L31N/QSD67LC/README.md

View this project on [CADLAB.io](https://cadlab.io/project/1322). 

# QSD67LC
Quickshifter for Triumph Daytona 675 Bj. 06-08
