L31N/QSD67LC/qsd67lc.sch.pdf

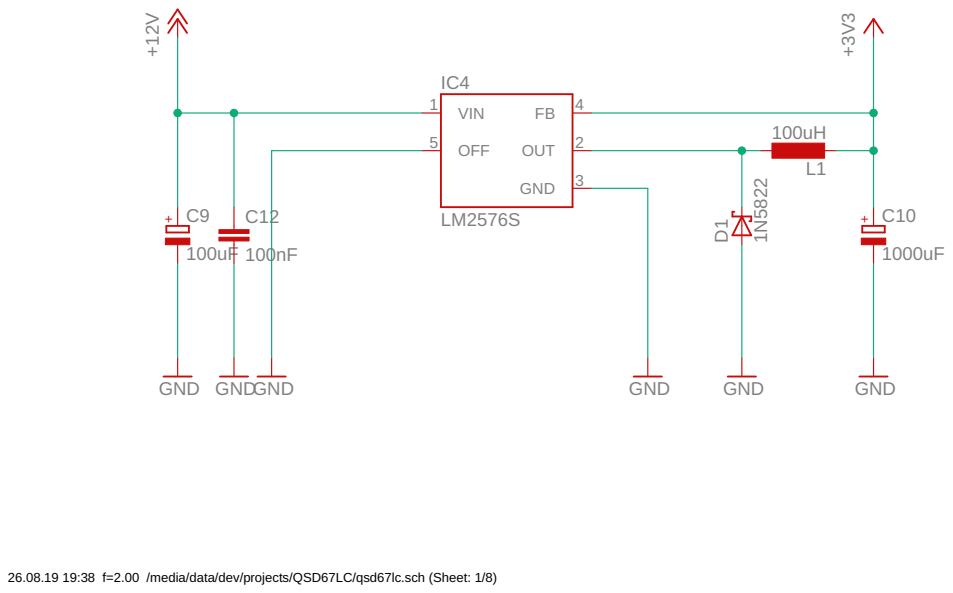
[picture p1: page 1]

26.08.19 19:38 f=2.00 /media/data/dev/projects/QSD67LC/qsd67lc.sch (Sheet: 1/8)

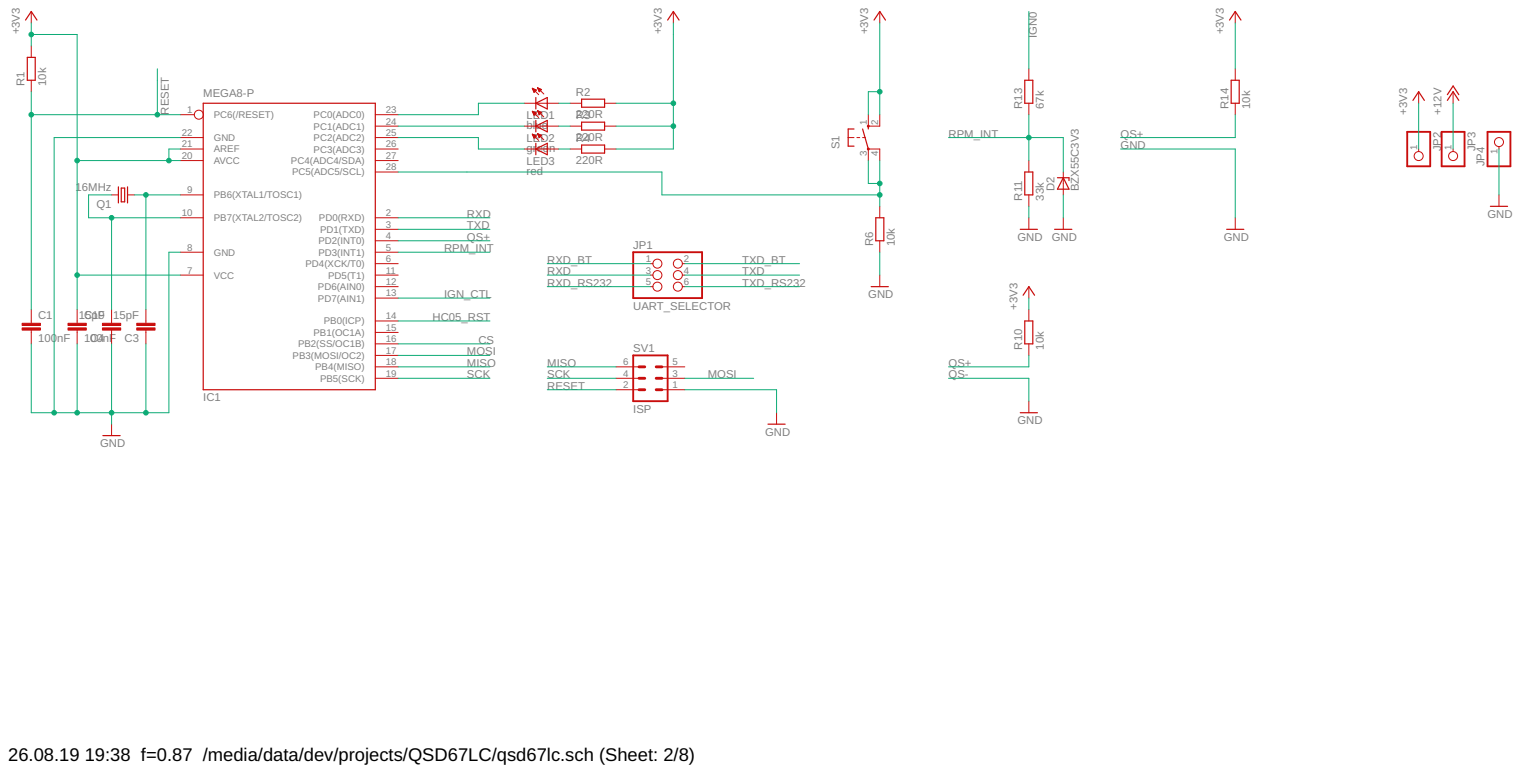
[picture p2: page 2]

26.08.19 19:38 f=0.87 /media/data/dev/projects/QSD67LC/qsd67lc.sch (Sheet: 2/8)

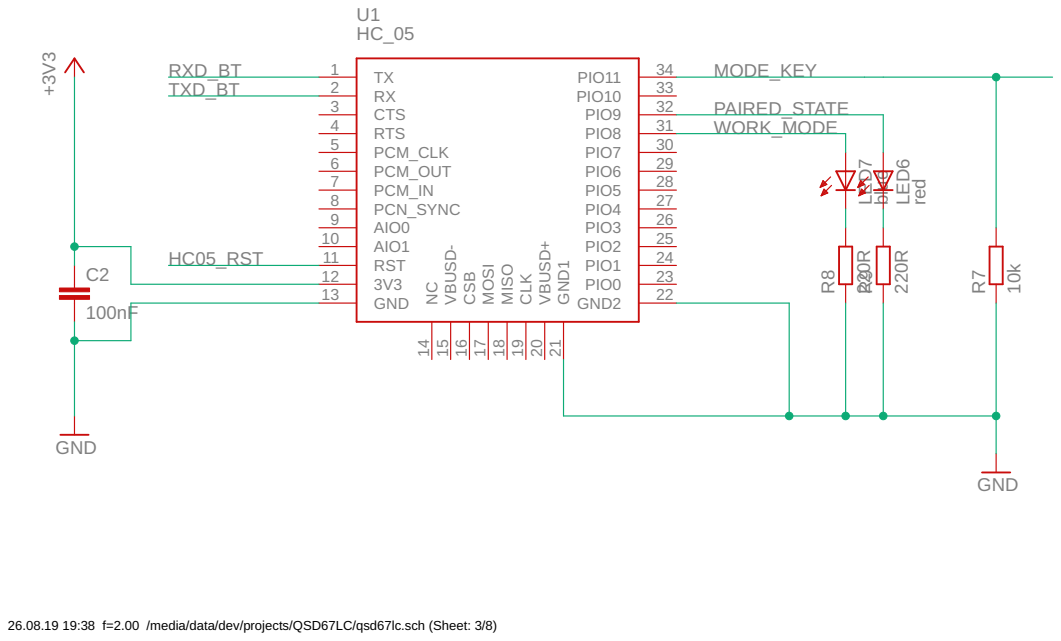
[picture p3: page 3]

26.08.19 19:38 f=2.00 /media/data/dev/projects/QSD67LC/qsd67lc.sch (Sheet: 3/8)

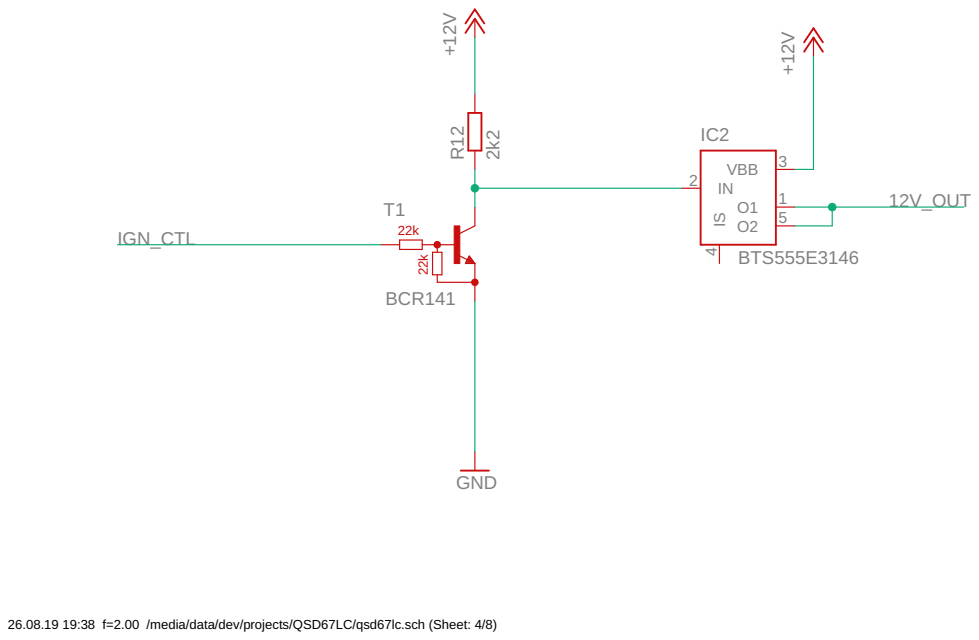
[picture p4: page 4]

26.08.19 19:38 f=2.00 /media/data/dev/projects/QSD67LC/qsd67lc.sch (Sheet: 4/8)

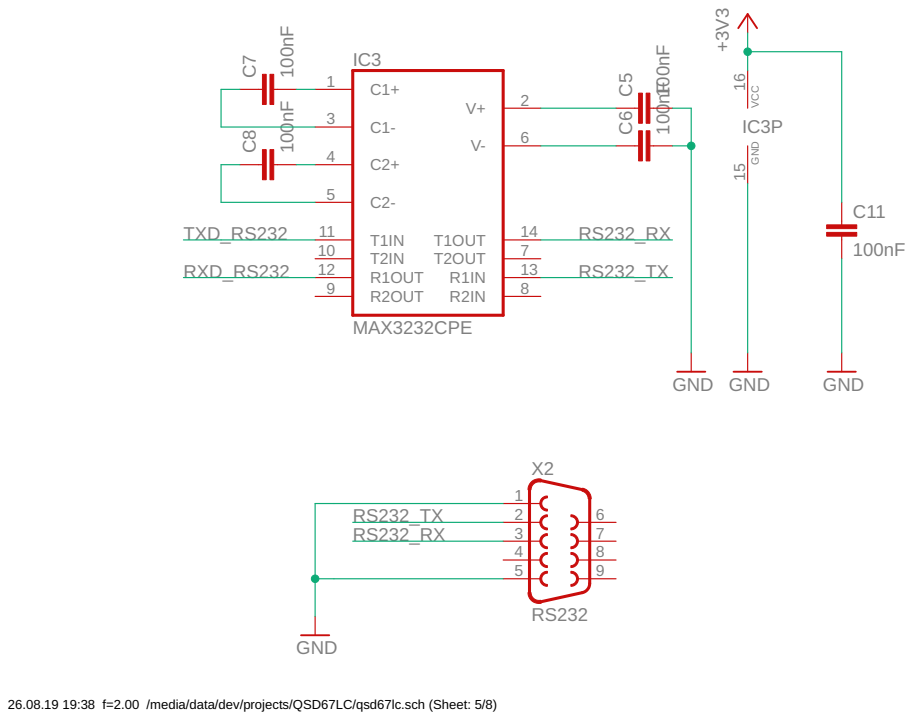
[picture p5: page 5]

26.08.19 19:38 f=2.00 /media/data/dev/projects/QSD67LC/qsd67lc.sch (Sheet: 5/8)

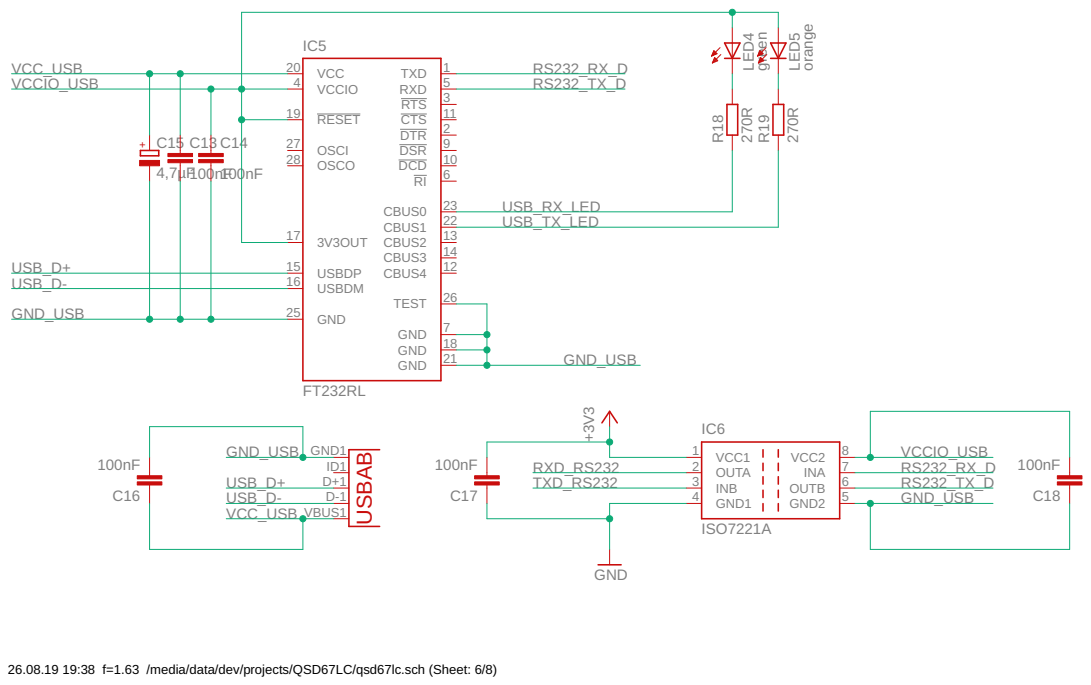
[picture p6: page 6]

26.08.19 19:38 f=1.63 /media/data/dev/projects/QSD67LC/qsd67lc.sch (Sheet: 6/8)

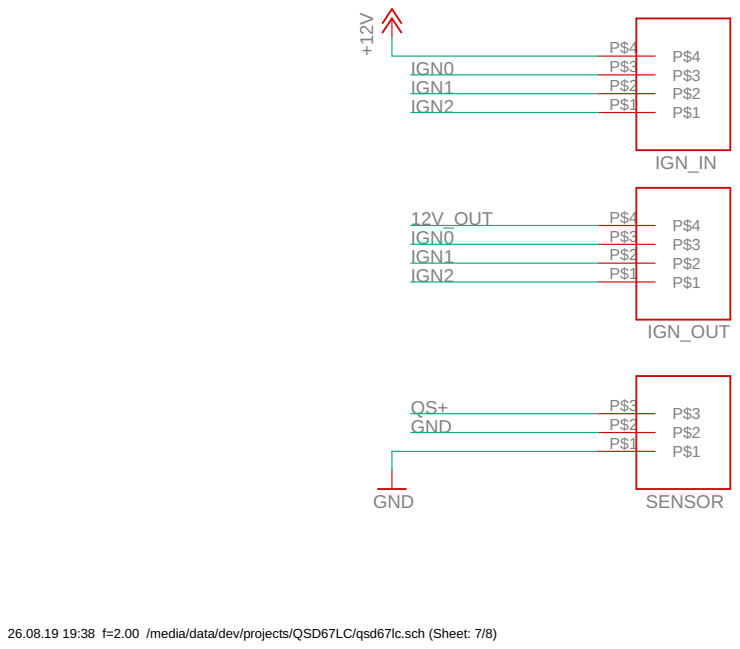
[picture p7: page 7]

26.08.19 19:38 f=2.00 /media/data/dev/projects/QSD67LC/qsd67lc.sch (Sheet: 7/8)

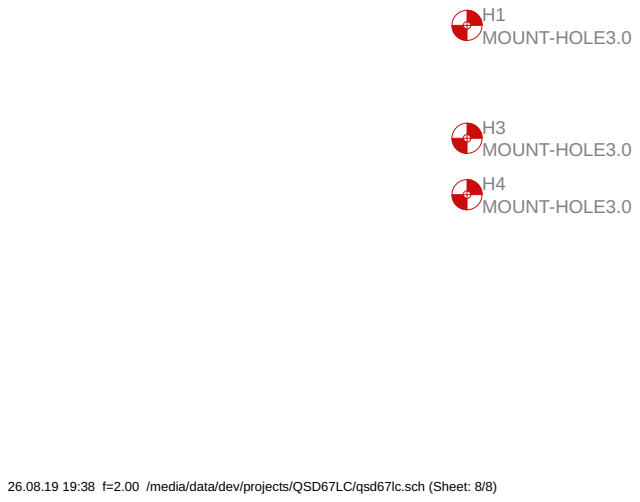
[picture p8: page 8]

26.08.19 19:38 f=2.00 /media/data/dev/projects/QSD67LC/qsd67lc.sch (Sheet: 8/8)
