L31N/QSD67LC/qsd67lc_btm.pdf

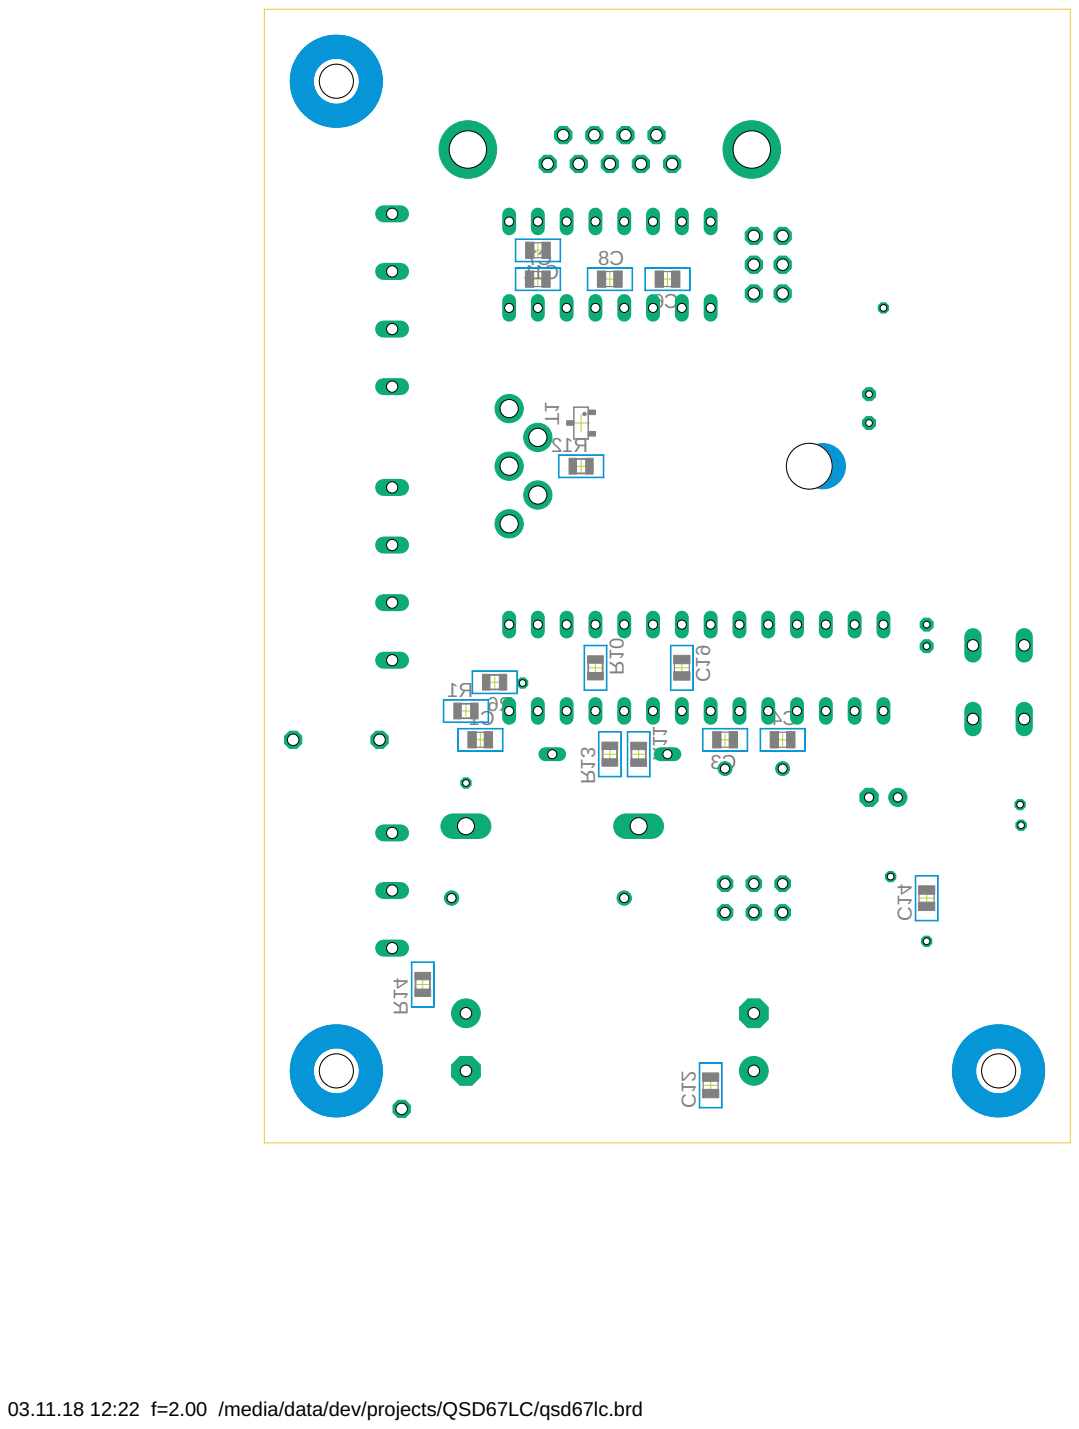
[picture p9: page 1]

03.11.18 12:22 f=2.00 /media/data/dev/projects/QSD67LC/qsd67lc.brd
