L31N/QSD67LC/infos/k-line-interface.pdf

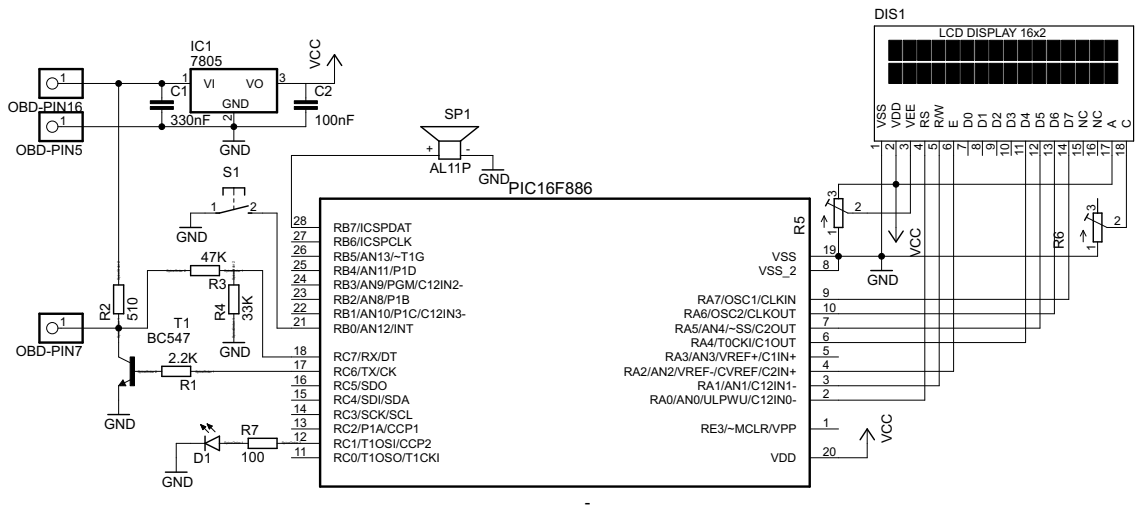
[picture p11: page 1]

SpiceOrder 1 SpiceOrder 2
