L31N/QSD67LC/qsd67lc.brd

## EAGLE design qsd67lc.brd (2020-06-22)

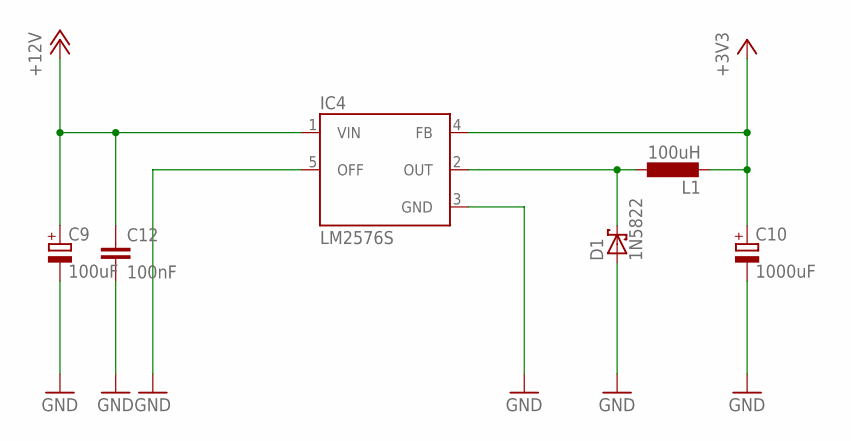
[picture p12: schematic qsd67lc.sch, sheet 1, Supply]

Parts:
C9: 100uF; E5-13
C10: 1000uF; E5-10,5
C12: 100nF; C0805
D1: 1N5822; DO201T15
IC4: LM2576S; TO263-5
L1: 100uH; 2200-15.24

Connections:
+3V3: C10.+, IC4.4 (FB), L1.2; also elsewhere on the board
+12V: C9.+, C12.1, IC4.1 (VIN); also elsewhere on the board
GND: C9.-, C10.-, C12.2, D1.A, IC4.3 (GND), IC4.5 (OFF); also elsewhere on the board
unnamed: D1.C, IC4.2 (OUT), L1.1

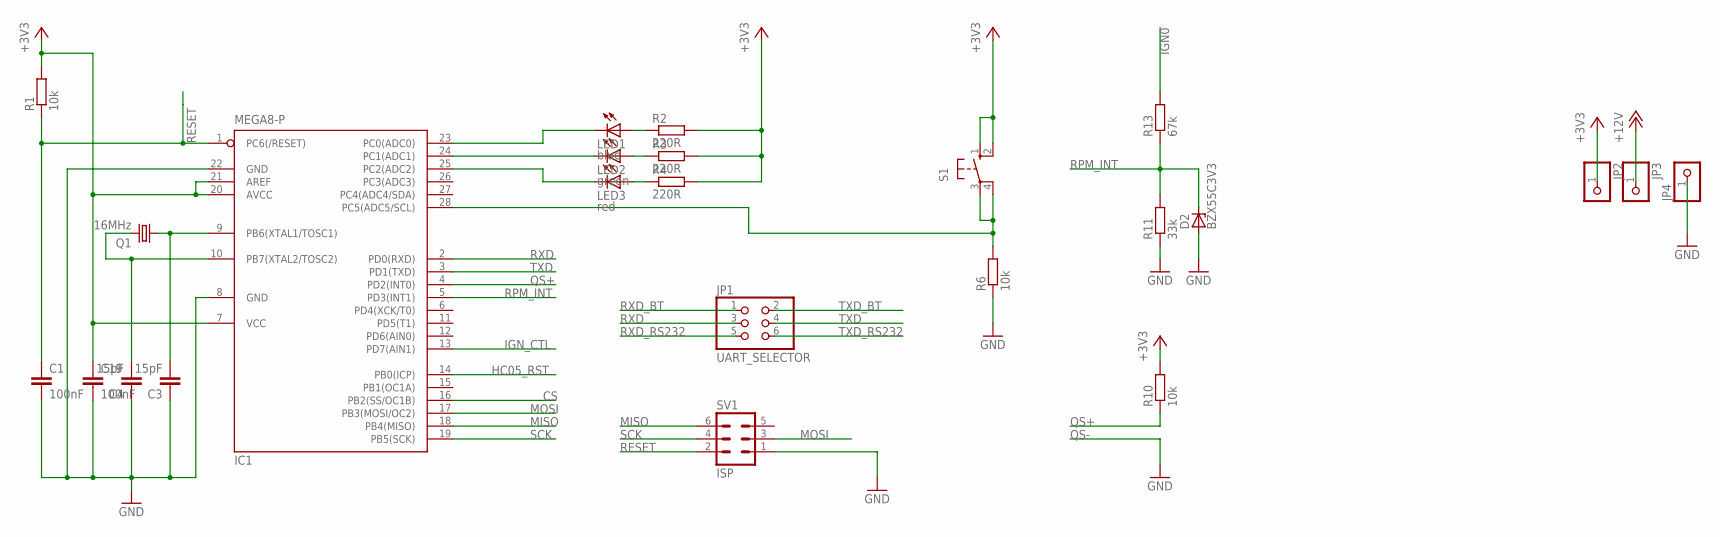
[picture p13: schematic qsd67lc.sch, sheet 2, atmega8]

Parts:
C1, C19: 100nF; C0805
C3, C4: 15pF; C0805
D2: BZX55C3V3; DO35Z10
IC1: MEGA8-P; DIL28-3
JP1: UART_SELECTOR; 2X03
JP2, JP3, JP4: PINHD-1X1; 1X01
LED1: blue; CHIP-LED0805
LED2: green; CHIP-LED0805
LED3: red; CHIP-LED0805
Q1: 16MHz; HC18U-V
R1, R6, R10: 10k; R0805
R2, R3, R4: 220R; R0805
R11: 33k; R0805
R13: 67k; R0805
S1: 10-XX; B3F-10XX
SV1: ISP; ML6

Connections:
+3V3: C19.1, IC1.7 (VCC), IC1.20 (AVCC), IC1.21 (AREF), JP2.1, R1.2, R2.2, R3.2, R4.2, R10.2, S1.1 (S), S1.2 (S1); also elsewhere on the board
+12V: JP3.1; also elsewhere on the board
CS: IC1.16 (PB2(SS/OC1B))
GND: C1.2, C3.1, C4.1, C19.2, D2.A, IC1.8 (GND), IC1.22 (GND), JP4.1, R6.1, R11.1, SV1.1; also elsewhere on the board
HC05_RST: IC1.14 (PB0(ICP)); also elsewhere on the board
IGN0: R13.2; also elsewhere on the board
IGN_CTL: IC1.13 (PD7(AIN1)); also elsewhere on the board
MISO: IC1.18 (PB4(MISO)), SV1.6
MOSI: IC1.17 (PB3(MOSI/OC2)), SV1.3
unnamed: IC1.24 (PC1(ADC1)), LED2.C
unnamed: C3.2, IC1.9 (PB6(XTAL1/TOSC1)), Q1.1
unnamed: C4.2, IC1.10 (PB7(XTAL2/TOSC2)), Q1.2
unnamed: LED2.A, R3.1
unnamed: LED1.A, R2.1
unnamed: LED3.A, R4.1
unnamed: IC1.23 (PC0(ADC0)), LED1.C
unnamed: IC1.25 (PC2(ADC2)), LED3.C
unnamed: IC1.28 (PC5(ADC5/SCL)), R6.2, S1.3, S1.4 (P1)
QS+: IC1.4 (PD2(INT0)), R10.1; also elsewhere on the board
RESET: C1.1, IC1.1 (PC6(/RESET)), R1.1, SV1.2
RPM_INT: D2.C, IC1.5 (PD3(INT1)), R11.2, R13.1
RXD: IC1.2 (PD0(RXD)), JP1.3
RXD_BT: JP1.1; also elsewhere on the board
RXD_RS232: JP1.5; also elsewhere on the board
SCK: IC1.19 (PB5(SCK)), SV1.4
TXD: IC1.3 (PD1(TXD)), JP1.4
TXD_BT: JP1.2; also elsewhere on the board
TXD_RS232: JP1.6; also elsewhere on the board

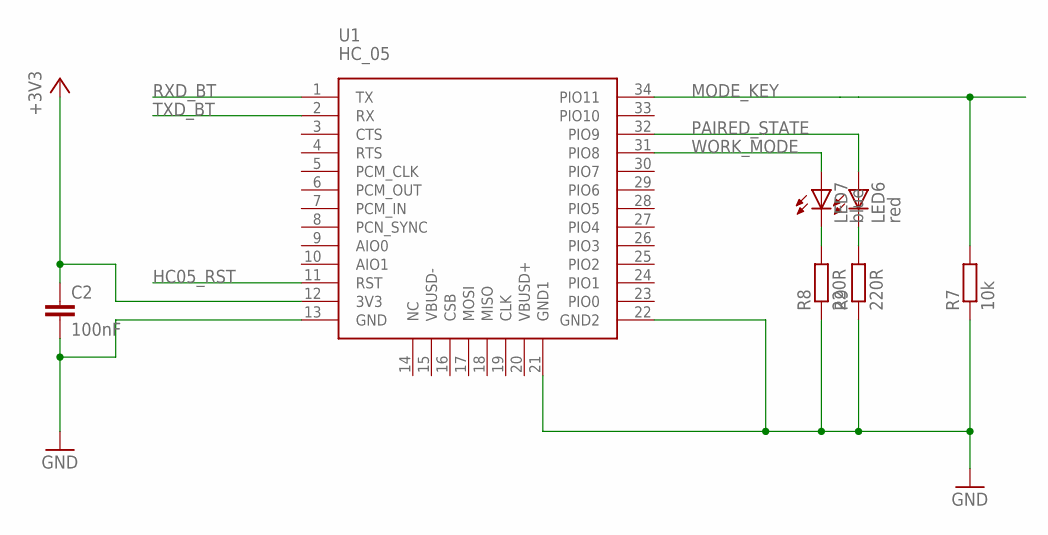
[picture p14: schematic qsd67lc.sch, sheet 3, bluetooth]

Parts:
C2: 100nF; C0805
LED6: red; CHIP-LED0805
LED7: blue; CHIP-LED0805
R7: 10k; R0805
R8, R9: 220R; R0805
U1: HC_05; BLUETOOTH_SMD

Connections:
+3V3: C2.1, U1.12 (3V3); also elsewhere on the board
GND: C2.2, R7.1, R8.1, R9.1, U1.13 (GND), U1.21 (GND1), U1.22 (GND2); also elsewhere on the board
HC05_RST: U1.11 (RST); also elsewhere on the board
MODE_KEY: R7.2, U1.34 (PIO11)
unnamed: LED7.C, R8.2
unnamed: LED6.C, R9.2
PAIRED_STATE: LED6.A, U1.32 (PIO9)
RXD_BT: U1.1 (TX); also elsewhere on the board
TXD_BT: U1.2 (RX); also elsewhere on the board
WORK_MODE: LED7.A, U1.31 (PIO8)

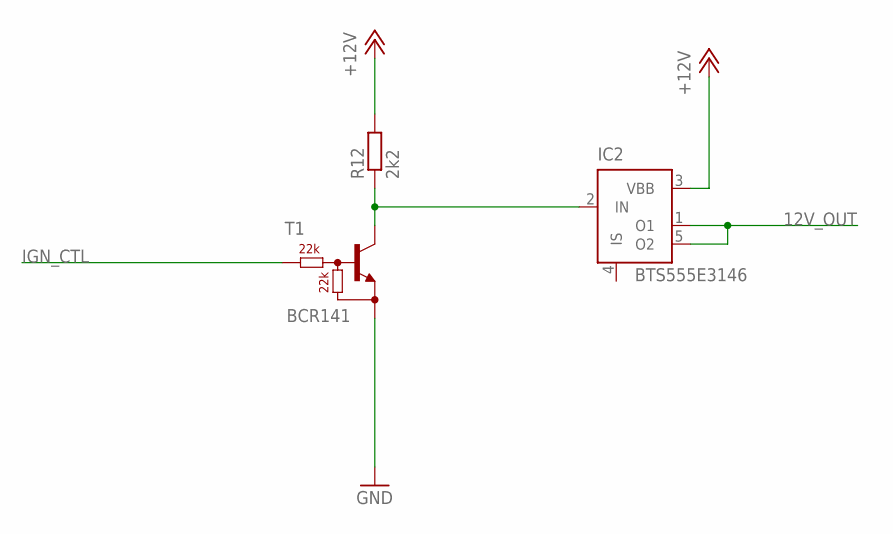
[picture p15: schematic qsd67lc.sch, sheet 4, ignition]

Parts:
IC2: BTS555E3146; TO220-52
R12: 2k2; R0805
T1: BCR141; SOT23-R_INFINEON

Connections:
12V_OUT: IC2.1 (O1), IC2.5 (O2); also elsewhere on the board
+12V: IC2.3 (VBB), R12.2; also elsewhere on the board
GND: T1.2 (E); also elsewhere on the board
IGN_CTL: T1.1 (B); also elsewhere on the board
unnamed: IC2.2 (IN), R12.1, T1.3 (C)

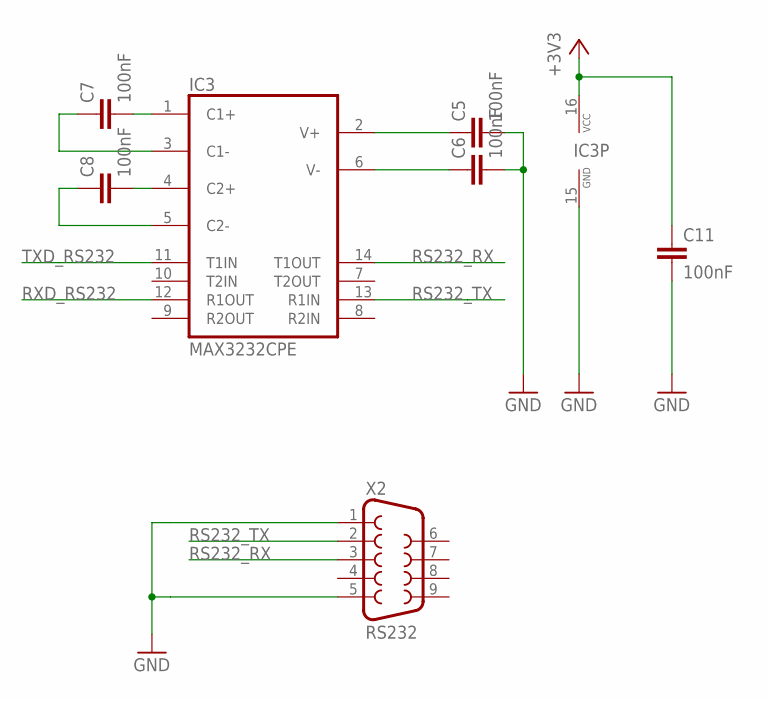
[picture p16: schematic qsd67lc.sch, sheet 5, RS232]

Parts:
C5, C6, C7, C8, C11: 100nF; C0805
IC3: MAX3232CPE; DIL16
X2: RS232; F09HP

Connections:
+3V3: C11.1, IC3.16 (VCC); also elsewhere on the board
GND: C5.2, C6.2, C11.2, IC3.15 (GND), X2.1, X2.5; also elsewhere on the board
unnamed: C5.1, IC3.2 (V+)
unnamed: C6.1, IC3.6 (V-)
unnamed: C7.2, IC3.1 (C1+)
unnamed: C8.2, IC3.4 (C2+)
unnamed: C8.1, IC3.5 (C2-)
unnamed: C7.1, IC3.3 (C1-)
RS232_RX: IC3.14 (T1OUT), X2.3
RS232_TX: IC3.13 (R1IN), X2.2
RXD_RS232: IC3.12 (R1OUT); also elsewhere on the board
TXD_RS232: IC3.11 (T1IN); also elsewhere on the board

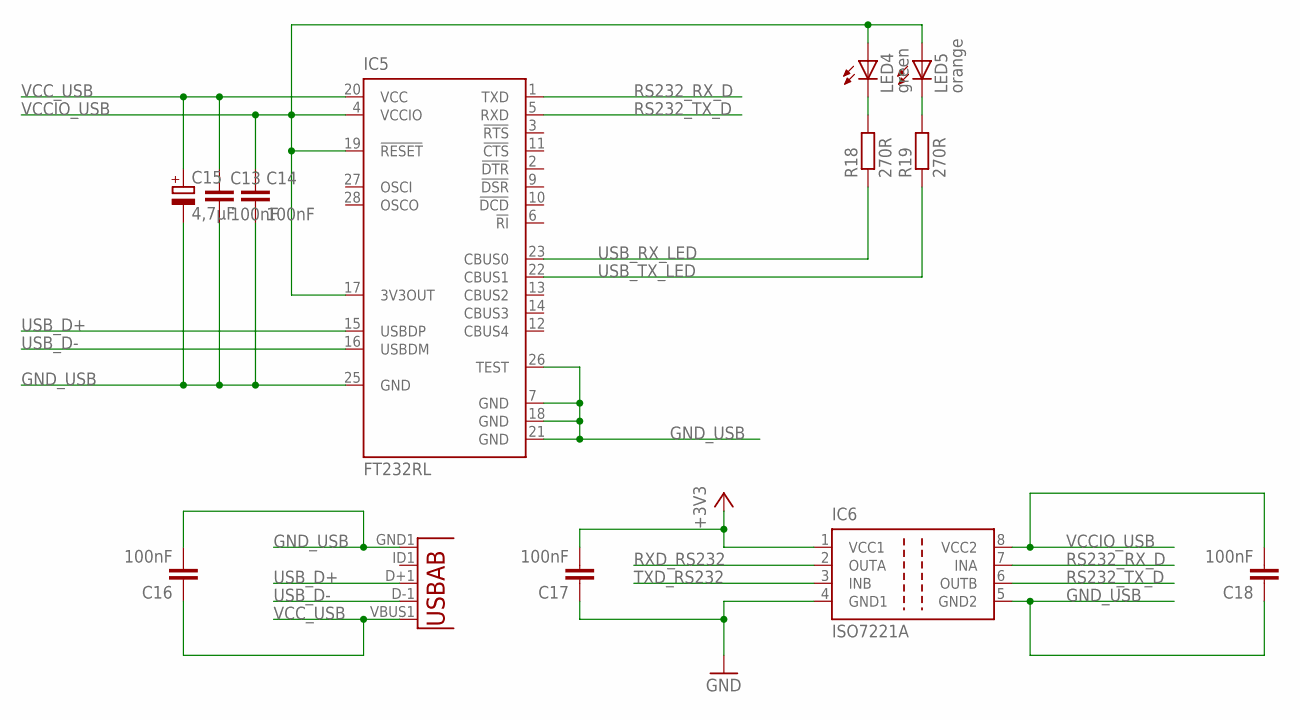
[picture p17: schematic qsd67lc.sch, sheet 6, USB FTDI]

Parts:
C13, C14, C16, C17, C18: 100nF; C0805
C15: 4,7µF; E2,5-5
IC5: FT232RL; SSOP28
IC6: ISO7221A; SO-08
LED4: green; SML0805
LED5: orange; SML0805
R18, R19: 270R; R0805
U2: USB""; USB-MICRO-SMD

Connections:
+3V3: C17.2, IC6.1 (VCC1); also elsewhere on the board
GND: C17.1, IC6.4 (GND1); also elsewhere on the board
GND_USB: C13.2, C14.2, C15.-, C16.2, C18.1, IC5.7 (GND), IC5.18 (GND), IC5.21 (GND), IC5.25 (GND), IC5.26 (TEST), IC6.5 (GND2), U2.GND1 (GND)
unnamed: LED4.C, R18.2
unnamed: LED5.C, R19.2
RS232_RX_D: IC5.1 (TXD), IC6.7 (INA)
RS232_TX_D: IC5.5 (RXD), IC6.6 (OUTB)
RXD_RS232: IC6.2 (OUTA); also elsewhere on the board
TXD_RS232: IC6.3 (INB); also elsewhere on the board
USB_D+: IC5.15 (USBDP), U2.D+1 (D+)
USB_D-: IC5.16 (USBDM), U2.D-1 (D-)
USB_RX_LED: IC5.23 (CBUS0), R18.1
USB_TX_LED: IC5.22 (CBUS1), R19.1
VCCIO_USB: C14.1, C18.2, IC5.4 (VCCIO), IC5.17 (3V3OUT), IC5.19 (!RESET), IC6.8 (VCC2), LED4.A, LED5.A
VCC_USB: C13.1, C15.+, C16.1, IC5.20 (VCC), U2.VBUS1 (VBUS)

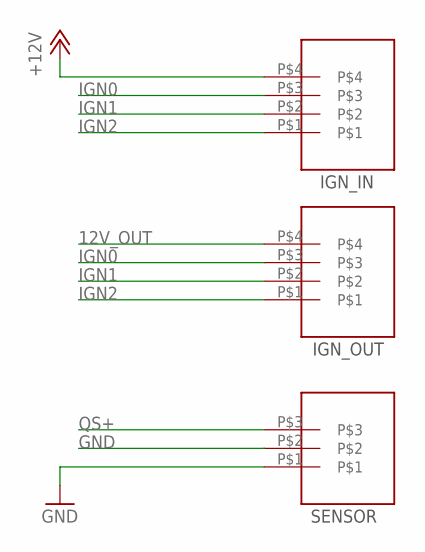
[picture p18: schematic qsd67lc.sch, sheet 7, Connectors]

Parts:
CON1, CON2: RIA-AKL-230-04; CON-RIA-P4
CON3: RIA-AKL-230-03; CON-RIA-P3

Connections:
12V_OUT: CON2.P$4; also elsewhere on the board
+12V: CON1.P$4; also elsewhere on the board
GND: CON3.P$1, CON3.P$2; also elsewhere on the board
IGN0: CON1.P$3, CON2.P$3; also elsewhere on the board
IGN1: CON1.P$2, CON2.P$2
IGN2: CON1.P$1, CON2.P$1
QS+: CON3.P$3; also elsewhere on the board

Notes on the sheet:
IGN_IN
IGN_OUT
SENSOR

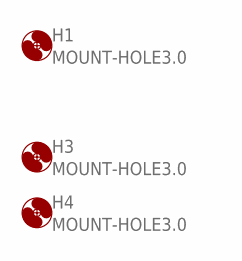
[picture p19: schematic qsd67lc.sch, sheet 8, holes]

Parts:
H1, H3, H4: MOUNT-HOLE3.0; 3,0

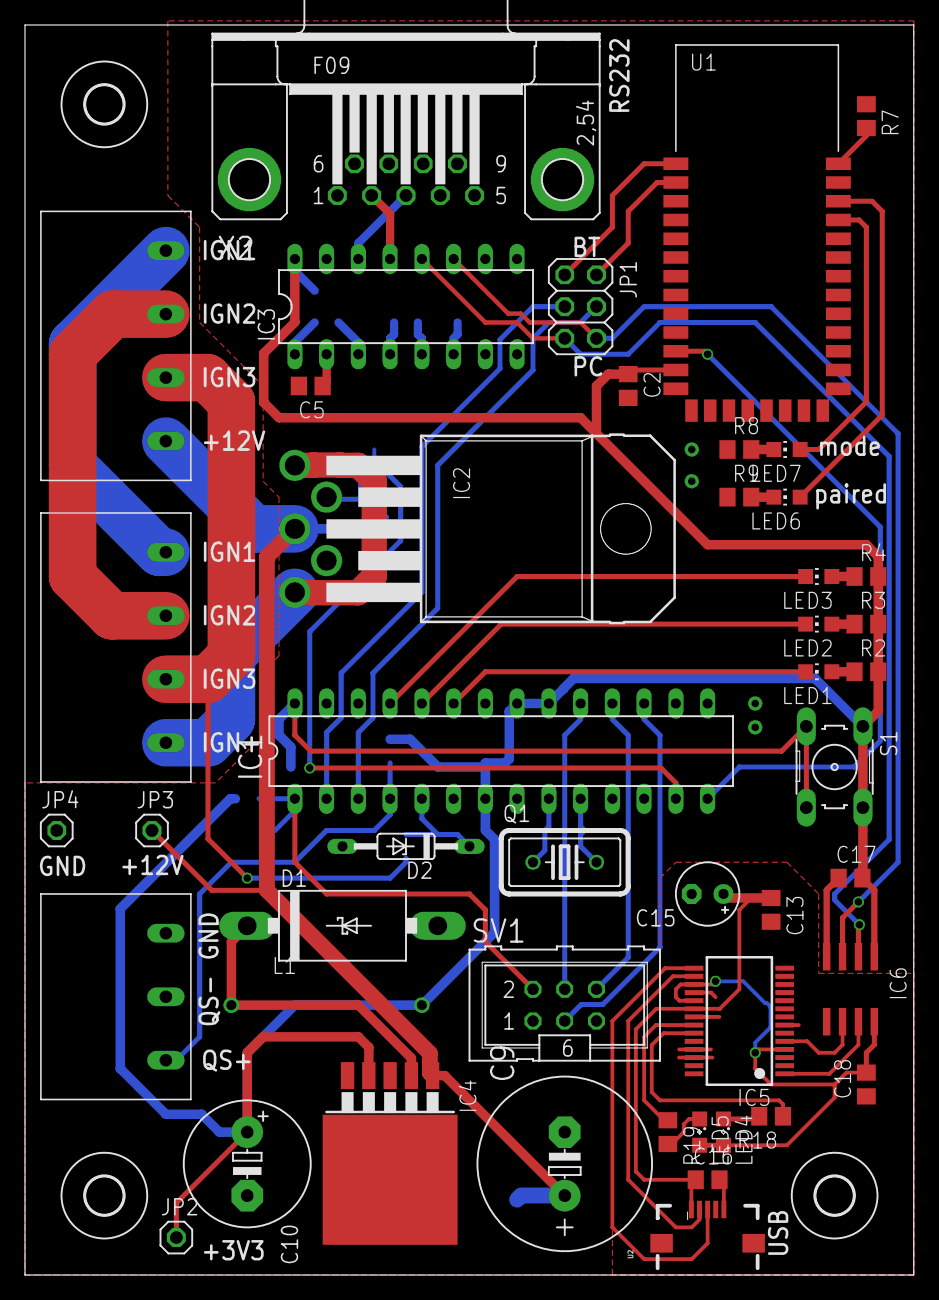
[picture p20: board qsd67lc.brd from above]

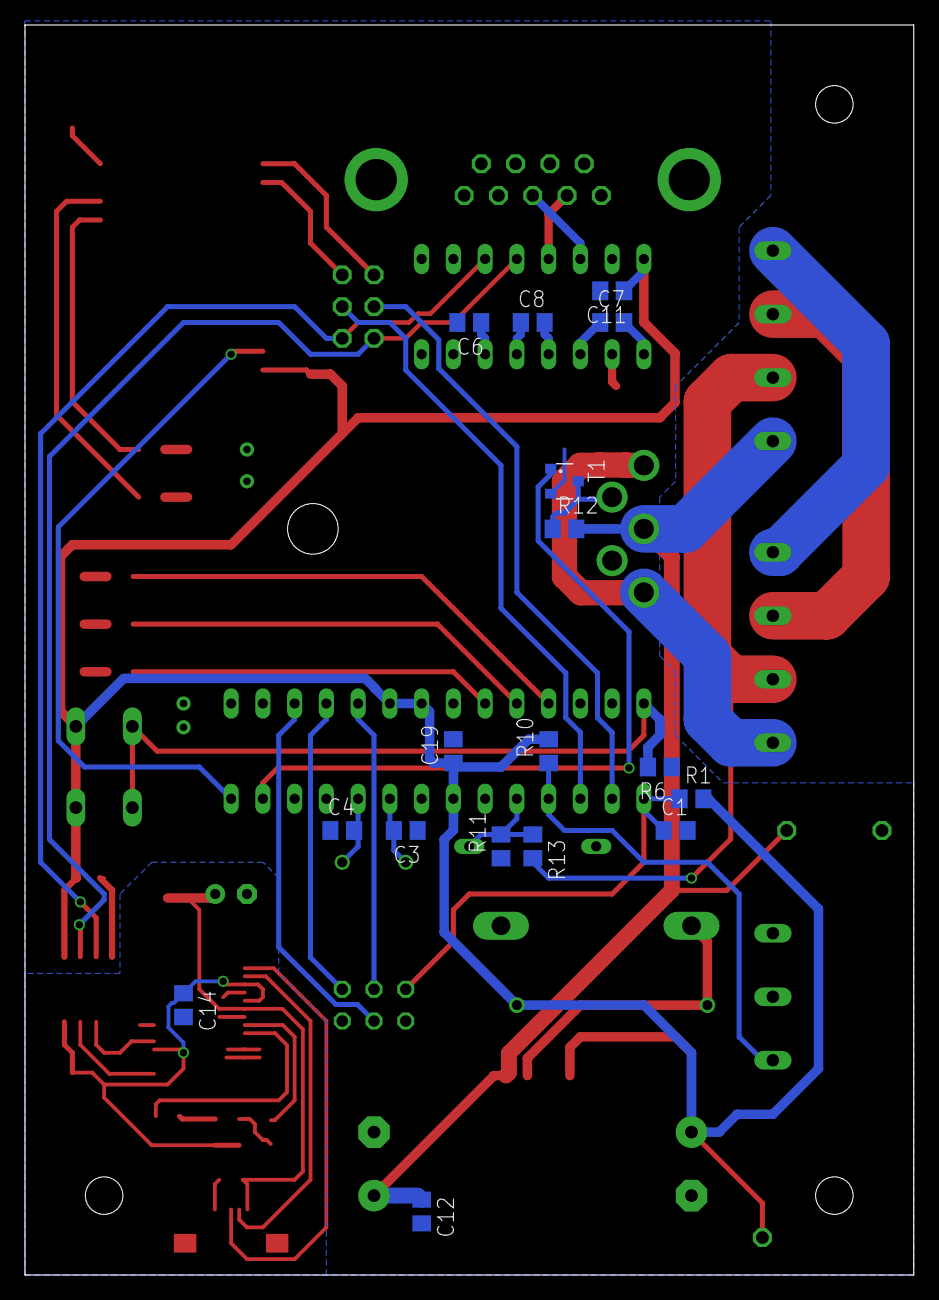
[picture p21: board qsd67lc.brd from below]

Board: 2 copper layers, 71.1 x 100.0 mm, 66 parts (17 on the bottom side), 56 nets.
