L31N/QSD67LC/k-line-adapter.brd

## EAGLE design k-line-adapter.brd (2020-06-19)

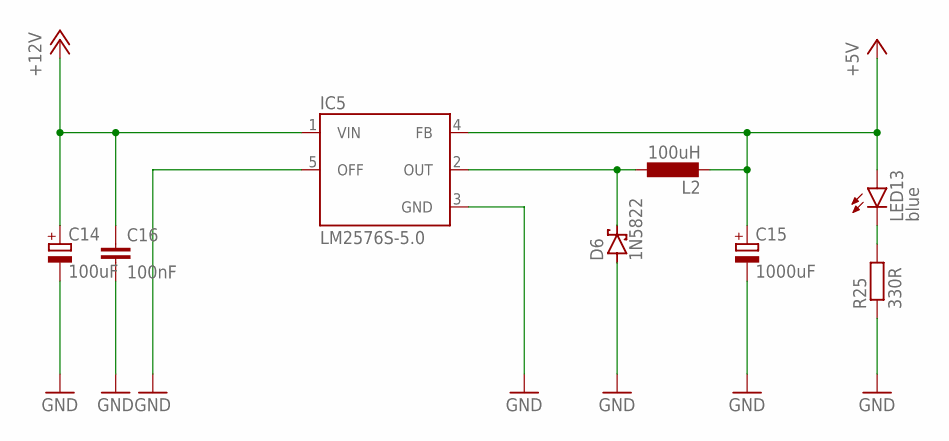
[picture p22: schematic k-line-adapter.sch, sheet 1, Power Supply]

Parts:
C14: 100uF; E5-10,5
C15: 1000uF; E5-10,5
C16: 100nF; C0805
D6: 1N5822; DO201T15
IC5: LM2576S-5.0; TO263-5
L2: 100uH; 09HCP
LED13: blue; CHIP-LED0805
R25: 330R; R0805

Connections:
+5V: C15.+, IC5.4 (FB), L2.P$2 (2), LED13.A; also elsewhere on the board
+12V: C14.+, C16.1, IC5.1 (VIN); also elsewhere on the board
GND: C14.-, C15.-, C16.2, D6.A, IC5.3 (GND), IC5.5 (OFF), R25.1; also elsewhere on the board
unnamed: D6.C, IC5.2 (OUT), L2.P$1 (1)
unnamed: LED13.C, R25.2

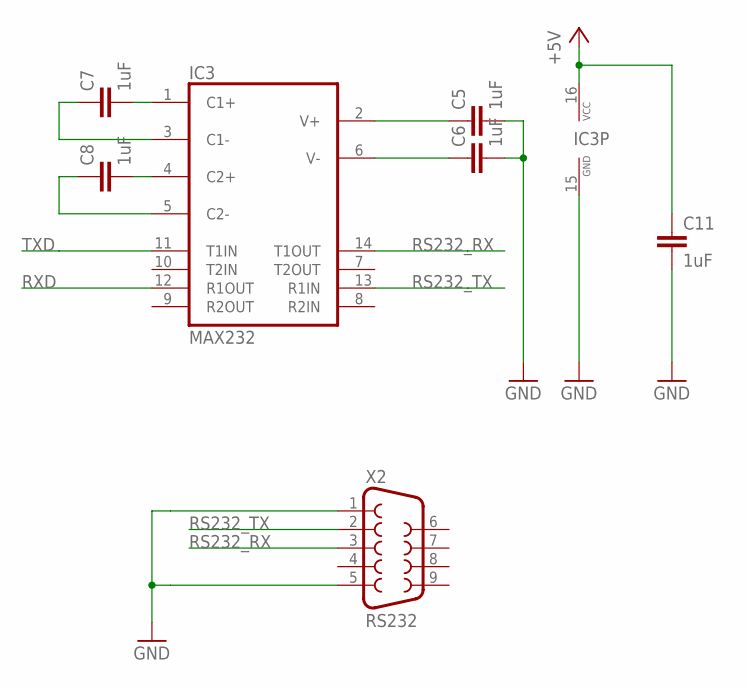
[picture p23: schematic k-line-adapter.sch, sheet 2, RS232 Interface]

Parts:
C5, C6, C7, C8, C11: 1uF; C0805
IC3: MAX232; DIL16
X2: RS232; F09HP

Connections:
+5V: C11.1, IC3.16 (VCC); also elsewhere on the board
GND: C5.2, C6.2, C11.2, IC3.15 (GND), X2.1, X2.5; also elsewhere on the board
unnamed: C5.1, IC3.2 (V+)
unnamed: C6.1, IC3.6 (V-)
unnamed: C7.2, IC3.1 (C1+)
unnamed: C8.2, IC3.4 (C2+)
unnamed: C8.1, IC3.5 (C2-)
unnamed: C7.1, IC3.3 (C1-)
RS232_RX: IC3.14 (T1OUT), X2.3
RS232_TX: IC3.13 (R1IN), X2.2
RXD: IC3.12 (R1OUT); also elsewhere on the board
TXD: IC3.11 (T1IN); also elsewhere on the board

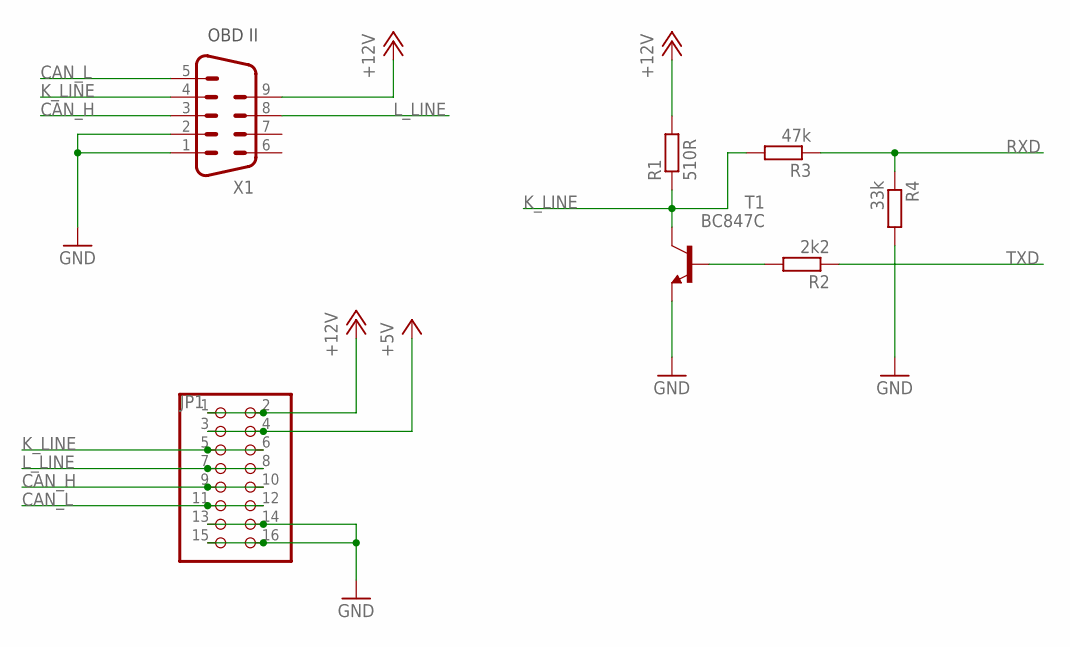
[picture p24: schematic k-line-adapter.sch, sheet 3, OBDII Interface]

Parts:
JP1: PINHD-2X8; 2X08
R1: 510R; R0805
R2: 2k2; R0805
R3: 47k; R0805
R4: 33k; R0805
T1: BC847C; SOT23-BEC
X1: M09HP

Connections:
+5V: JP1.3, JP1.4; also elsewhere on the board
+12V: JP1.1, JP1.2, R1.2, X1.9; also elsewhere on the board
CAN_H: JP1.9, JP1.10, X1.3
CAN_L: JP1.11, JP1.12, X1.5
GND: JP1.13, JP1.14, JP1.15, JP1.16, R4.2, T1.E, X1.1, X1.2; also elsewhere on the board
K_LINE: JP1.5, JP1.6, R1.1, R3.2, T1.C, X1.4
L_LINE: JP1.7, JP1.8, X1.8
unnamed: R2.2, T1.B
RXD: R3.1, R4.1; also elsewhere on the board
TXD: R2.1; also elsewhere on the board

Notes on the sheet:
OBD II

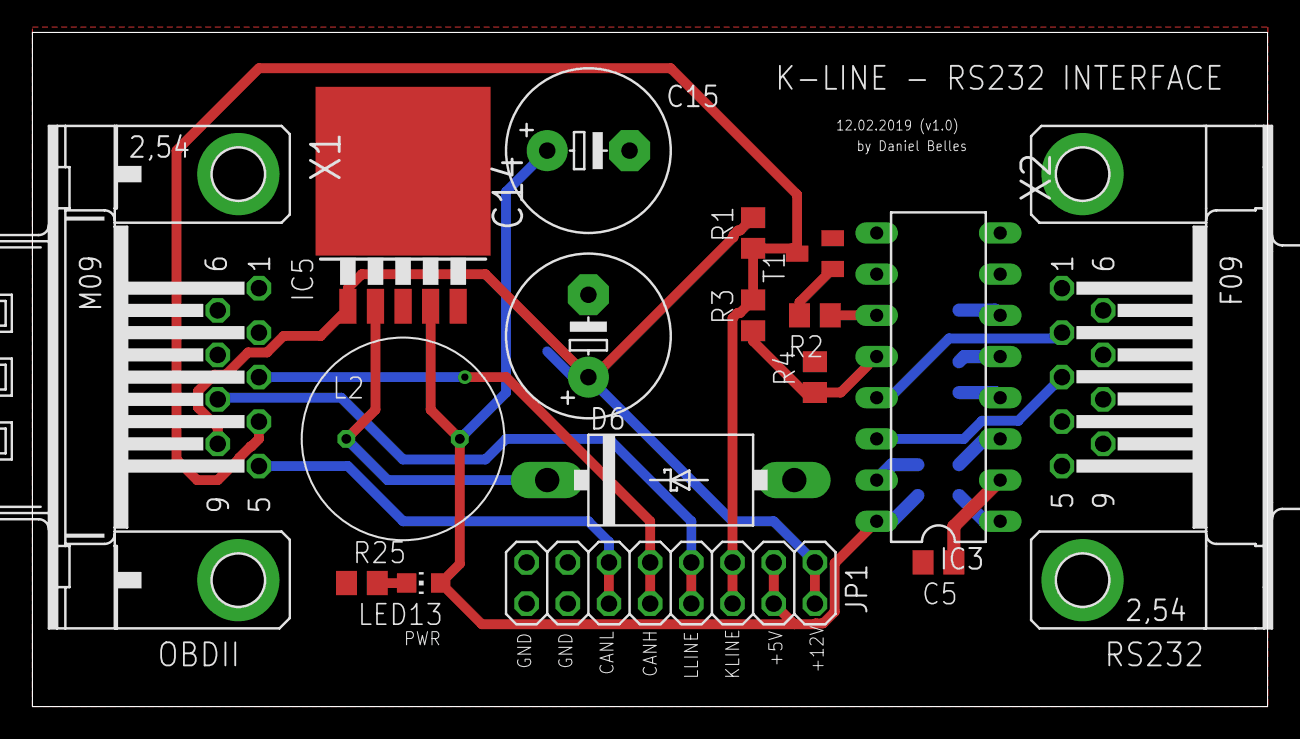
[picture p25: board k-line-adapter.brd from above]

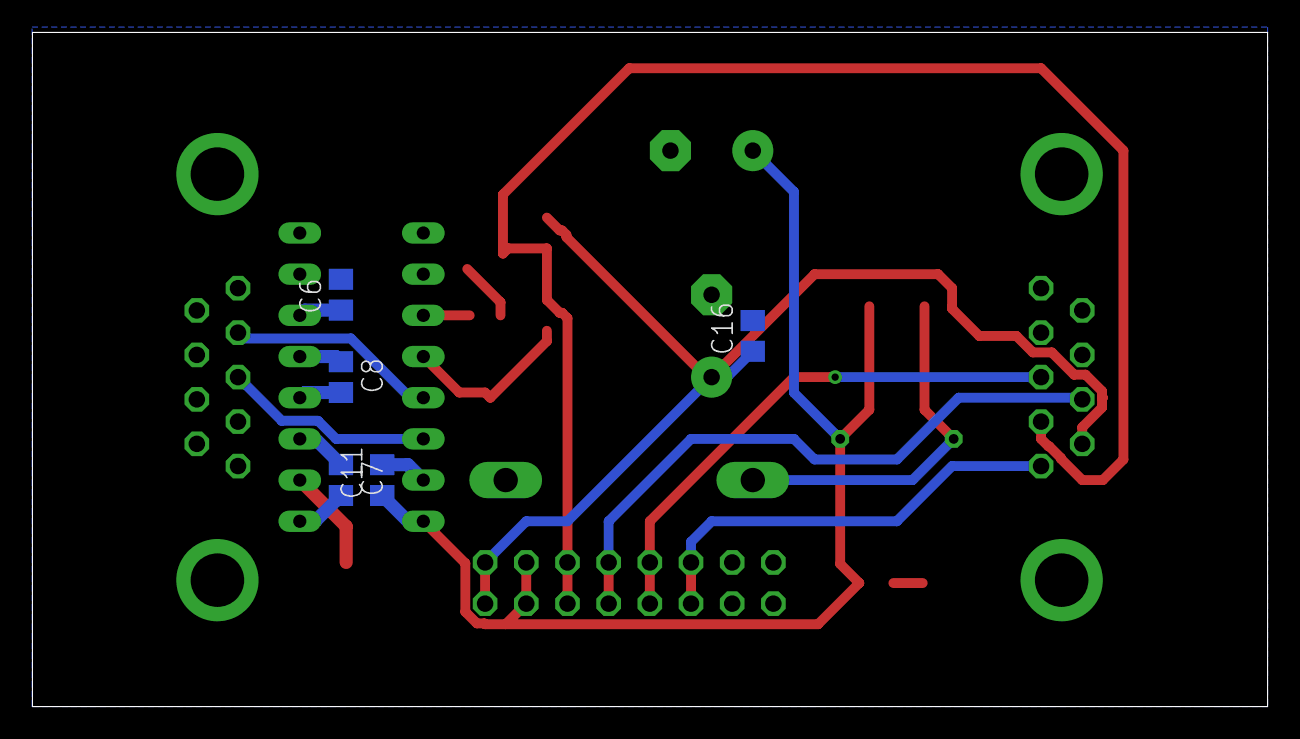
[picture p26: board k-line-adapter.brd from below]

Board: 2 copper layers, 76.2 x 41.6 mm, 22 parts (5 on the bottom side), 20 nets.
