L31N/QSD67LC/qsd67lc_v2.brd

## EAGLE design qsd67lc_v2.brd (2020-06-19, an earlier design)

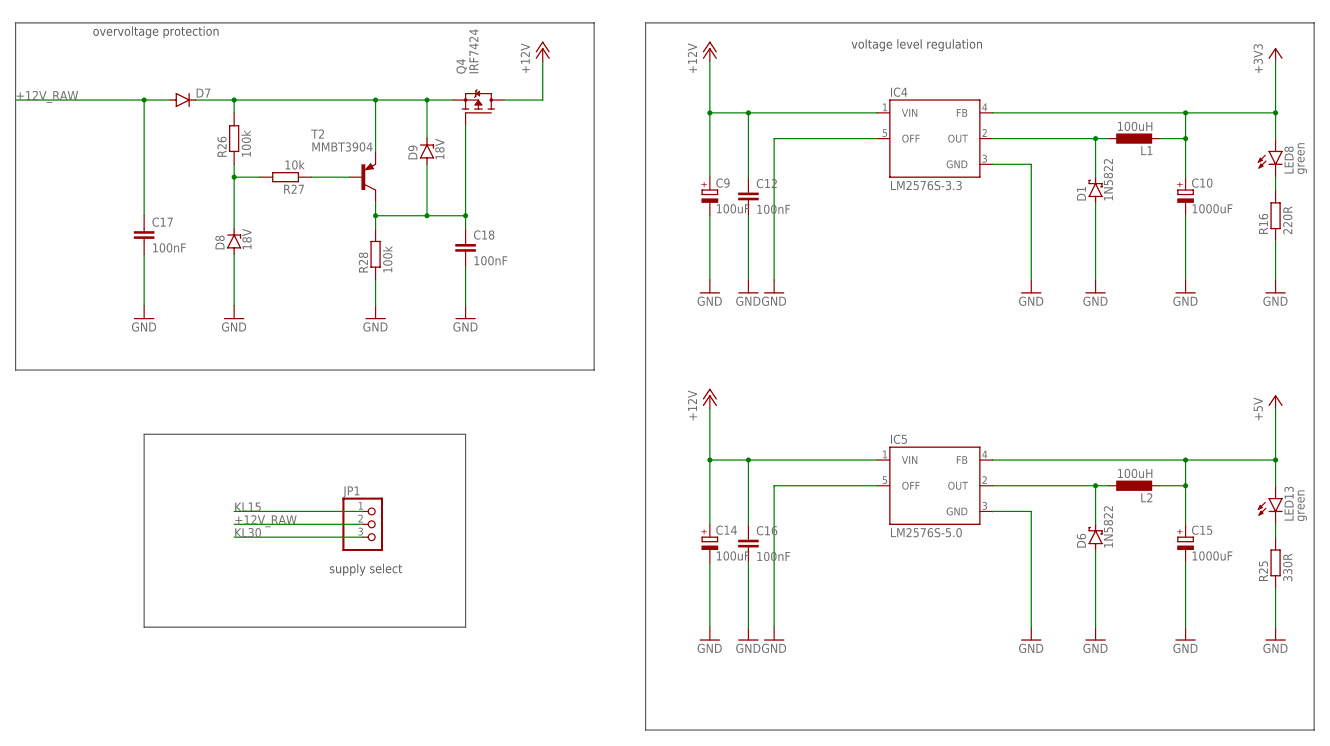
[picture p27: schematic qsd67lc_v2.sch, sheet 1, Supply]

Parts:
C9, C14: 100uF; E5-10,5
C10, C15: 1000uF; E5-10,5
C12, C16, C17, C18: 100nF; C0805
D1, D6: 1N5822; DO201T15
D7: DIODE-SOD123; SOD123
D8, D9: 18V; SOD80C
IC4: LM2576S-3.3; TO263-5
IC5: LM2576S-5.0; TO263-5
JP1: PINHD-1X3; 1X03
L1, L2: 100uH; 09HCP
LED8, LED13: green; CHIP-LED0805
Q4: IRF7424; SO-8
R16: 220R; R0805
R25: 330R; R0805
R26, R28: 100k; R0805
R27: 10k; R0805
T2: MMBT3904; SOT23-BEC

Connections:
+3V3: C10.+, IC4.4 (FB), L1.P$2 (2), LED8.A; also elsewhere on the board
+5V: C15.+, IC5.4 (FB), L2.P$2 (2), LED13.A; also elsewhere on the board
+12V: C9.+, C12.1, C14.+, C16.1, IC4.1 (VIN), IC5.1 (VIN), Q4.5 (D), Q4.6 (D), Q4.7 (D), Q4.8 (D); also elsewhere on the board
+12V_RAW: C17.1, D7.A, JP1.2
GND: C9.-, C10.-, C12.2, C14.-, C15.-, C16.2, C17.2, C18.2, D1.A, D6.A, D8.A, IC4.3 (GND), IC4.5 (OFF), IC5.3 (GND), IC5.5 (OFF), R16.1, R25.1, R28.1; also elsewhere on the board
KL15: JP1.1; also elsewhere on the board
KL30: JP1.3; also elsewhere on the board
unnamed: LED8.C, R16.2
unnamed: D7.C, D9.C, Q4.1 (S), Q4.2 (S), Q4.3 (S), R26.2, T2.E
unnamed: D1.C, IC4.2 (OUT), L1.P$1 (1)
unnamed: D6.C, IC5.2 (OUT), L2.P$1 (1)
unnamed: LED13.C, R25.2
unnamed: D8.C, R26.1, R27.2
unnamed: R27.1, T2.B
unnamed: C18.1, D9.A, Q4.4 (G), R28.2, T2.C

Notes on the sheet:
supply select
overvoltage protection
voltage level regulation

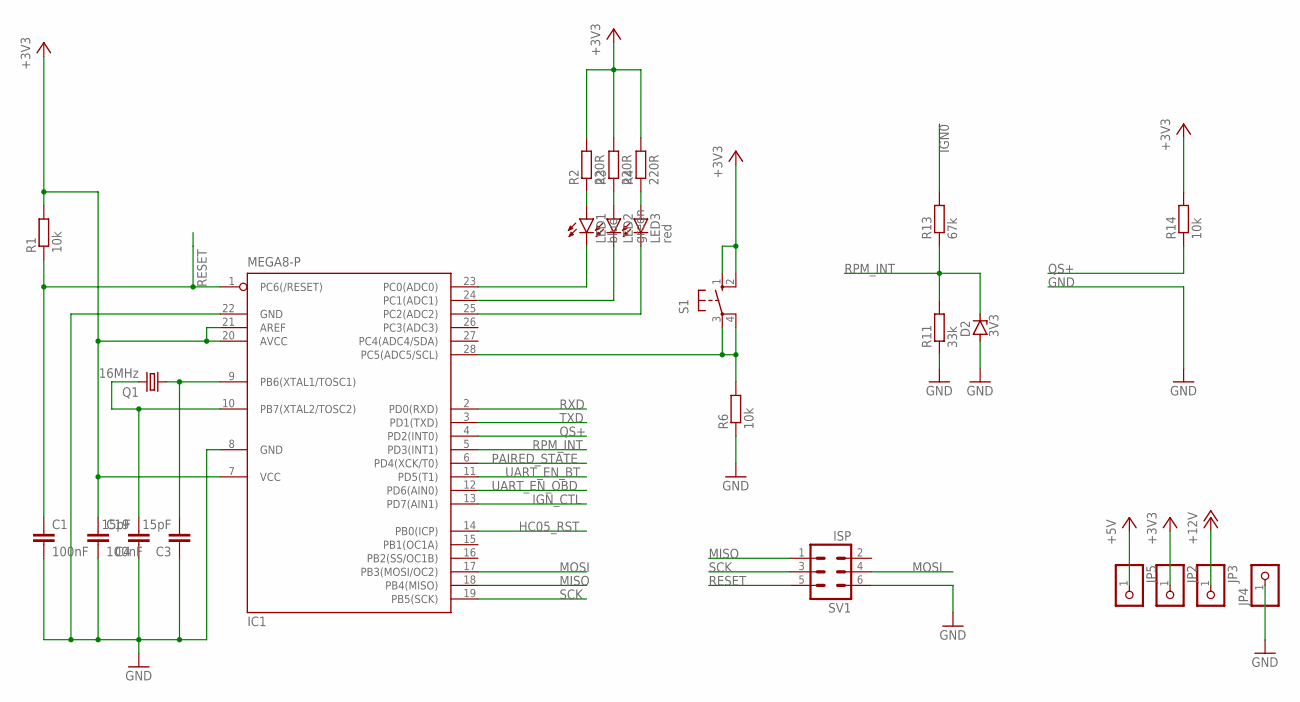
[picture p28: schematic qsd67lc_v2.sch, sheet 2, atmega8]

Parts:
C1, C19: 100nF; C0805
C3, C4: 15pF; C0805
D2: 3V3; SOD80C
IC1: MEGA8-P; DIL28-3
JP2, JP3, JP4, JP5: PINHD-1X1; 1X01
LED1: blue; CHIP-LED0805
LED2: green; CHIP-LED0805
LED3: red; CHIP-LED0805
Q1: 16MHz; HC49U-V
R1, R6, R14: 10k; R0805
R2, R3, R4: 220R; R0805
R11: 33k; R0805
R13: 67k; R0805
S1: 10-XX; B3F-10XX
SV1: ISP; ML6

Connections:
+3V3: C19.1, IC1.7 (VCC), IC1.20 (AVCC), IC1.21 (AREF), JP2.1, R1.2, R2.2, R3.2, R4.2, R14.2, S1.1 (S), S1.2 (S1); also elsewhere on the board
+5V: JP5.1; also elsewhere on the board
+12V: JP3.1; also elsewhere on the board
GND: C1.2, C3.1, C4.1, C19.2, D2.A, IC1.8 (GND), IC1.22 (GND), JP4.1, R6.1, R11.1, SV1.6; also elsewhere on the board
HC05_RST: IC1.14 (PB0(ICP)); also elsewhere on the board
IGN0: R13.2; also elsewhere on the board
IGN_CTL: IC1.13 (PD7(AIN1)); also elsewhere on the board
MISO: IC1.18 (PB4(MISO)), SV1.1
MOSI: IC1.17 (PB3(MOSI/OC2)), SV1.4
unnamed: C3.2, IC1.9 (PB6(XTAL1/TOSC1)), Q1.1
unnamed: C4.2, IC1.10 (PB7(XTAL2/TOSC2)), Q1.2
unnamed: LED2.A, R3.1
unnamed: LED1.A, R2.1
unnamed: LED3.A, R4.1
unnamed: IC1.23 (PC0(ADC0)), LED1.C
unnamed: IC1.24 (PC1(ADC1)), LED2.C
unnamed: IC1.28 (PC5(ADC5/SCL)), R6.2, S1.3, S1.4 (P1)
unnamed: IC1.25 (PC2(ADC2)), LED3.C
PAIRED_STATE: IC1.6 (PD4(XCK/T0)); also elsewhere on the board
QS+: IC1.4 (PD2(INT0)), R14.1; also elsewhere on the board
RESET: C1.1, IC1.1 (PC6(/RESET)), R1.1, SV1.5
RPM_INT: D2.C, IC1.5 (PD3(INT1)), R11.2, R13.1
RXD: IC1.2 (PD0(RXD)); also elsewhere on the board
SCK: IC1.19 (PB5(SCK)), SV1.3
TXD: IC1.3 (PD1(TXD)); also elsewhere on the board
UART_EN_BT: IC1.11 (PD5(T1)); also elsewhere on the board
UART_EN_OBD: IC1.12 (PD6(AIN0)); also elsewhere on the board

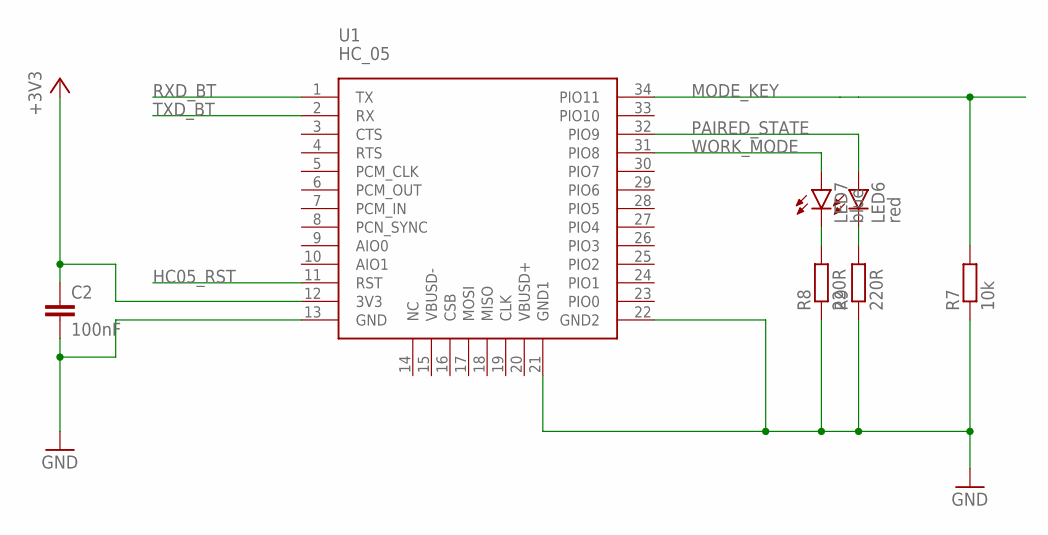
[picture p29: schematic qsd67lc_v2.sch, sheet 3, bluetooth]

Parts:
C2: 100nF; C0805
LED6: red; CHIP-LED0805
LED7: blue; CHIP-LED0805
R7: 10k; R0805
R8, R9: 220R; R0805
U1: HC_05; BLUETOOTH_SMD

Connections:
+3V3: C2.1, U1.12 (3V3); also elsewhere on the board
GND: C2.2, R7.1, R8.1, R9.1, U1.13 (GND), U1.21 (GND1), U1.22 (GND2); also elsewhere on the board
HC05_RST: U1.11 (RST); also elsewhere on the board
MODE_KEY: R7.2, U1.34 (PIO11)
unnamed: LED7.C, R8.2
unnamed: LED6.C, R9.2
PAIRED_STATE: LED6.A, U1.32 (PIO9); also elsewhere on the board
RXD_BT: U1.1 (TX); also elsewhere on the board
TXD_BT: U1.2 (RX); also elsewhere on the board
WORK_MODE: LED7.A, U1.31 (PIO8)

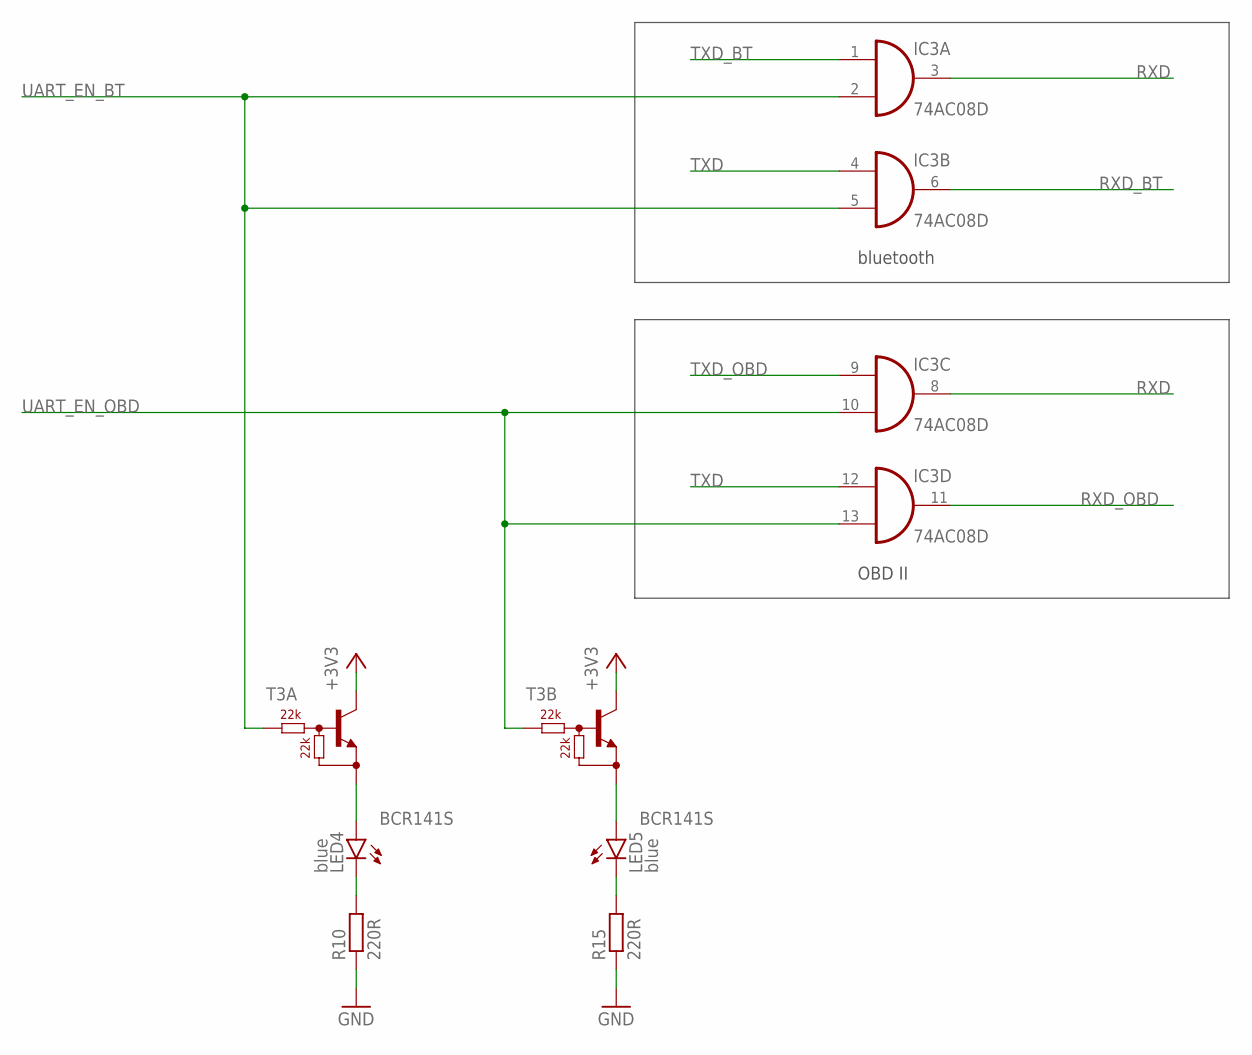
[picture p30: schematic qsd67lc_v2.sch, sheet 4, UART switch logic]

Parts:
IC3: 74AC08D; SO14
LED4, LED5: blue; CHIP-LED0805
R10, R15: 220R; M0805
T3: BCR141S; SOT363_INFINEON

Connections:
+3V3: T3.3 (C), T3.6 (C); also elsewhere on the board
GND: IC3.7 (GND), R10.1, R15.1; also elsewhere on the board
unnamed: LED4.C, R10.2
unnamed: LED5.C, R15.2
unnamed: LED4.A, T3.1 (E)
unnamed: LED5.A, T3.4 (E)
RXD: IC3.3 (O), IC3.8 (O); also elsewhere on the board
RXD_BT: IC3.6 (O); also elsewhere on the board
RXD_OBD: IC3.11 (O); also elsewhere on the board
TXD: IC3.4 (I0), IC3.12 (I0); also elsewhere on the board
TXD_BT: IC3.1 (I0); also elsewhere on the board
TXD_OBD: IC3.9 (I0); also elsewhere on the board
UART_EN_BT: IC3.2 (I1), IC3.5 (I1), T3.2 (B); also elsewhere on the board
UART_EN_OBD: IC3.10 (I1), IC3.13 (I1), T3.5 (B); also elsewhere on the board
VCC: IC3.14 (VCC)

Notes on the sheet:
bluetooth
OBD II

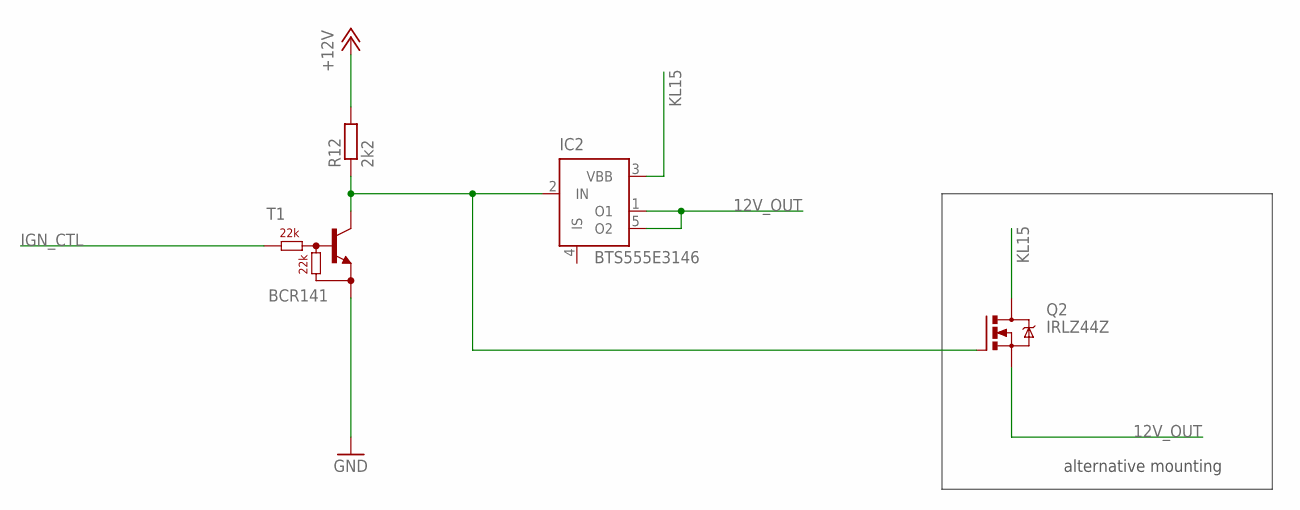
[picture p31: schematic qsd67lc_v2.sch, sheet 5, ignition]

Parts:
IC2: BTS555E3146; TO220-52
Q2: IRLZ44Z; TO220BH
R12: 2k2; R0805
T1: BCR141; SOT23-R_INFINEON

Connections:
12V_OUT: IC2.1 (O1), IC2.5 (O2), Q2.S; also elsewhere on the board
+12V: R12.2; also elsewhere on the board
GND: T1.2 (E); also elsewhere on the board
IGN_CTL: T1.1 (B); also elsewhere on the board
KL15: IC2.3 (VBB), Q2.D; also elsewhere on the board
unnamed: IC2.2 (IN), Q2.G, R12.1, T1.3 (C)

Notes on the sheet:
alternative mounting
