L31N/QSD67LC/qsd67lc_v2.brd

## EAGLE design qsd67lc_v2.brd (continued)

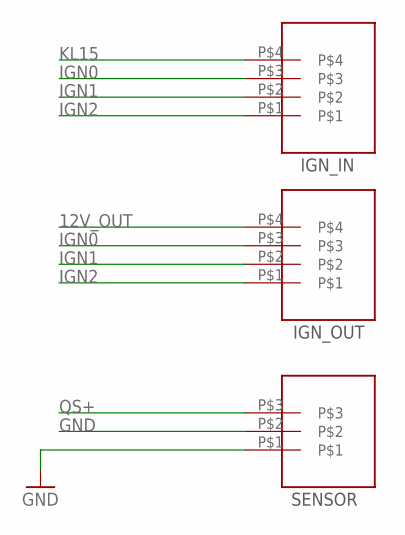
[picture p32: schematic qsd67lc_v2.sch, sheet 6, Connectors]

Parts:
CON1, CON2: RIA-AKL-230-04; CON-RIA-P4
CON3: RIA-AKL-230-03; CON-RIA-P3

Connections:
12V_OUT: CON2.P$4; also elsewhere on the board
GND: CON3.P$1, CON3.P$2; also elsewhere on the board
IGN0: CON1.P$3, CON2.P$3; also elsewhere on the board
IGN1: CON1.P$2, CON2.P$2
IGN2: CON1.P$1, CON2.P$1
KL15: CON1.P$4; also elsewhere on the board
QS+: CON3.P$3; also elsewhere on the board

Notes on the sheet:
IGN_IN
IGN_OUT
SENSOR

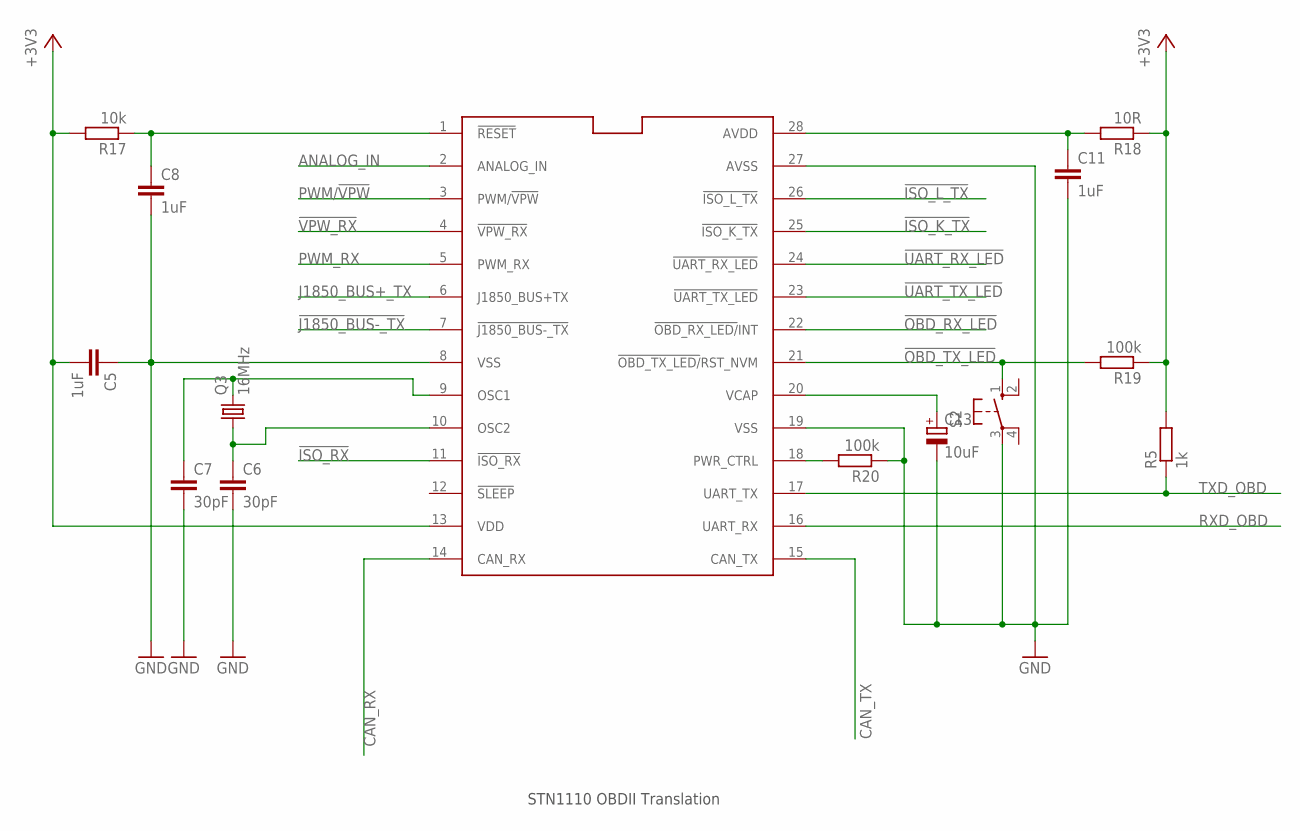
[picture p33: schematic qsd67lc_v2.sch, sheet 7, OBDII STN1110]

Parts:
C5, C8, C11: 1uF; C0805
C6, C7: 30pF; C0805
C13: 10uF; E2-5
Q3: 16MHz; HC49U-V
R5: 1k; R0805
R17: 10k; R0805
R18: 10R; R0805
R19, R20: 100k; R0805
S2: RST_NVM; B3F-10XX
U$1: STN1110-SOIC28; SOIC28L

Connections:
!ISO_K_TX: U$1.25 (!ISO_K_TX); also elsewhere on the board
!ISO_L_TX: U$1.26 (!ISO_L_TX); also elsewhere on the board
!ISO_RX: U$1.11 (!ISO_RX); also elsewhere on the board
!J1850_BUS-_TX: U$1.7 (!J1850_BUS-_TX); also elsewhere on the board
!OBD_RX_LED: U$1.22 (!OBD_RX_LED/!INT); also elsewhere on the board
!OBD_TX_LED: R19.2, S2.1 (S), U$1.21 (!OBD_TX_LED/!RST_NVM); also elsewhere on the board
!UART_RX_LED: U$1.24 (!UART_RX_LED); also elsewhere on the board
!UART_TX_LED: U$1.23 (!UART_TX_LED); also elsewhere on the board
!VPW_RX: U$1.4 (!VPW_RX); also elsewhere on the board
+3V3: C5.2, R5.2, R17.2, R18.1, R19.1, U$1.13 (VDD); also elsewhere on the board
ANALOG_IN: U$1.2 (ANALOG_IN)
CAN_RX: U$1.14 (CAN_RX); also elsewhere on the board
CAN_TX: U$1.15 (CAN_TX); also elsewhere on the board
GND: C5.1, C6.2, C7.2, C8.2, C11.2, C13.-, R20.1, S2.3, U$1.8 (VSS), U$1.19 (VSS), U$1.27 (AVSS); also elsewhere on the board
J1850_BUS+_TX: U$1.6 (J1850_BUS+TX); also elsewhere on the board
unnamed: C8.1, R17.1, U$1.1 (!RESET)
unnamed: C7.1, Q3.2, U$1.9 (OSC1)
unnamed: C11.1, R18.2, U$1.28 (AVDD)
unnamed: C6.1, Q3.1, U$1.10 (OSC2)
unnamed: C13.+, U$1.20 (VCAP)
unnamed: R20.2, U$1.18 (PWR_CTRL)
PWM/!VPW: U$1.3 (PWM/!VPW); also elsewhere on the board
PWM_RX: U$1.5 (PWM_RX); also elsewhere on the board
RXD_OBD: U$1.16 (UART_RX); also elsewhere on the board
TXD_OBD: R5.1, U$1.17 (UART_TX); also elsewhere on the board

Notes on the sheet:
STN1110 OBDII Translation

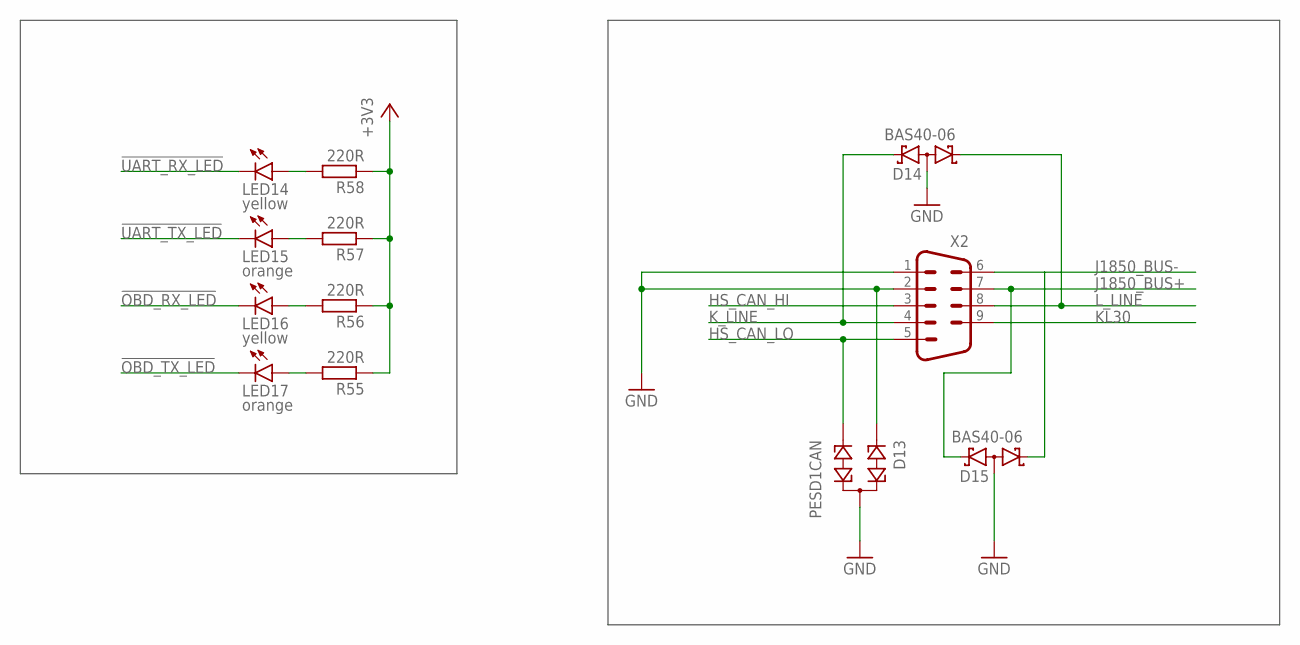
[picture p34: schematic qsd67lc_v2.sch, sheet 8, OBDII peripherals]

Parts:
D13: PESD1CAN; SOT23
D14, D15: BAS40-06; SOT23
LED14, LED16: yellow; CHIP-LED0805
LED15, LED17: orange; CHIP-LED0805
R55, R56, R57, R58: 220R; R0805
X2: M09HP

Connections:
!OBD_RX_LED: LED16.C; also elsewhere on the board
!OBD_TX_LED: LED17.C; also elsewhere on the board
!UART_RX_LED: LED14.C; also elsewhere on the board
!UART_TX_LED: LED15.C; also elsewhere on the board
+3V3: R55.1, R56.1, R57.1, R58.1; also elsewhere on the board
GND: D13.1, D13.3, D14.3 (AA), D15.3 (AA), X2.1, X2.2; also elsewhere on the board
HS_CAN_HI: X2.3; also elsewhere on the board
HS_CAN_LO: D13.2, X2.5; also elsewhere on the board
J1850_BUS+: D15.2 (K2), X2.7; also elsewhere on the board
J1850_BUS-: D15.1 (K1), X2.6; also elsewhere on the board
KL30: X2.9; also elsewhere on the board
K_LINE: D14.2 (K2), X2.4; also elsewhere on the board
L_LINE: D14.1 (K1), X2.8; also elsewhere on the board
unnamed: LED17.A, R55.2
unnamed: LED16.A, R56.2
unnamed: LED15.A, R57.2
unnamed: LED14.A, R58.2

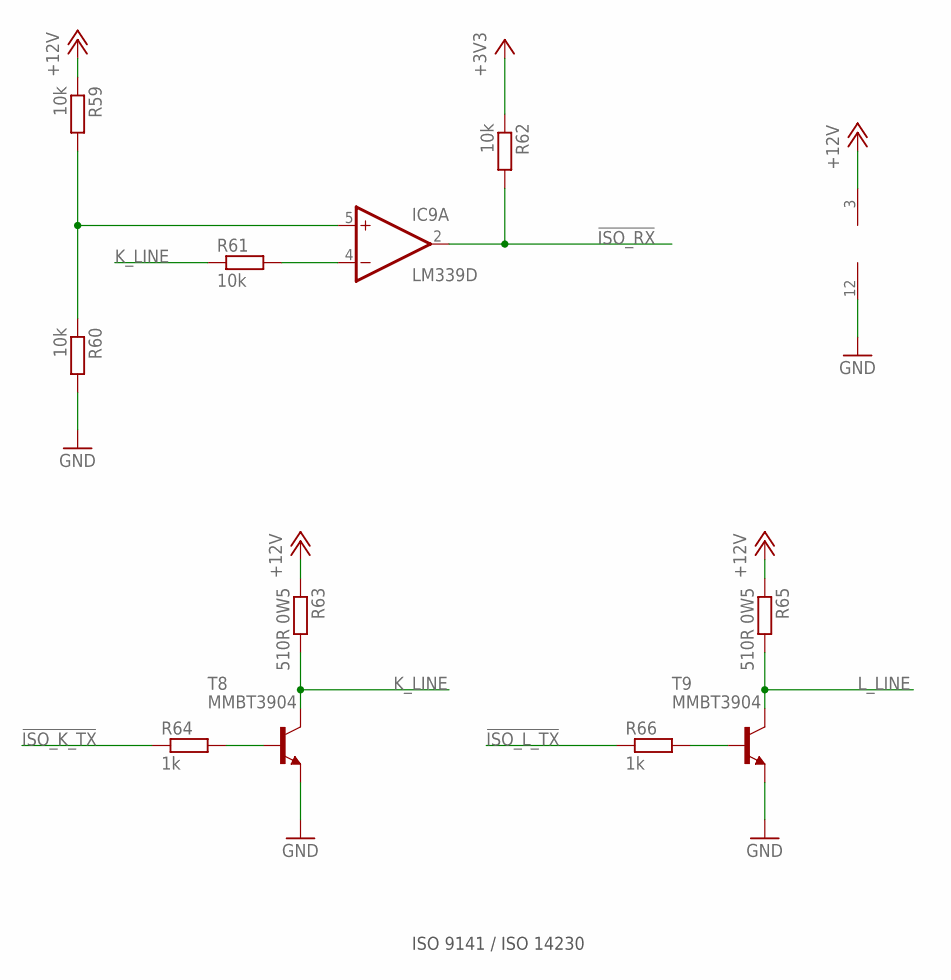
[picture p35: schematic qsd67lc_v2.sch, sheet 9, OBDII ISO 9141]

Parts:
IC9: LM339D; SO14
R59, R60, R61, R62: 10k; R0805
R63, R65: 510R 0W5; 0207/12
R64, R66: 1k; R0805
T8, T9: MMBT3904; SOT23-BEC

Connections:
!ISO_K_TX: R64.1; also elsewhere on the board
!ISO_L_TX: R66.1; also elsewhere on the board
!ISO_RX: IC9.2 (OUT), R62.2; also elsewhere on the board
+3V3: R62.1; also elsewhere on the board
+12V: IC9.3 (V+), R59.1, R63.1, R65.1; also elsewhere on the board
GND: IC9.12 (GND), R60.2, T8.E, T9.E; also elsewhere on the board
K_LINE: R61.1, R63.2, T8.C; also elsewhere on the board
L_LINE: R65.2, T9.C; also elsewhere on the board
unnamed: IC9.5 (+IN), R59.2, R60.1
unnamed: IC9.4 (-IN), R61.2
unnamed: R64.2, T8.B
unnamed: R66.2, T9.B

Notes on the sheet:
ISO 9141 / ISO 14230

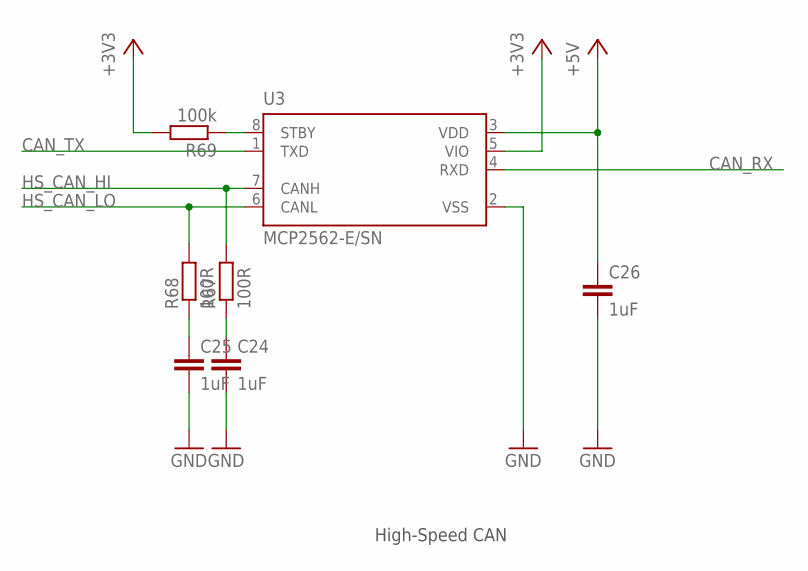
[picture p36: schematic qsd67lc_v2.sch, sheet 10, OBDII CAN]

Parts:
C24, C25, C26: 1uF; C0805
R67, R68: 100R; R0805
R69: 100k; R0805
U3: MCP2562-E/SN; SOIC127P600X175-8N

Connections:
+3V3: R69.2, U3.5 (VIO); also elsewhere on the board
+5V: C26.1, U3.3 (VDD); also elsewhere on the board
CAN_RX: U3.4 (RXD); also elsewhere on the board
CAN_TX: U3.1 (TXD); also elsewhere on the board
GND: C24.2, C25.2, C26.2, U3.2 (VSS); also elsewhere on the board
HS_CAN_HI: R67.2, U3.7 (CANH); also elsewhere on the board
HS_CAN_LO: R68.2, U3.6 (CANL); also elsewhere on the board
unnamed: C25.1, R68.1
unnamed: C24.1, R67.1
unnamed: R69.1, U3.8 (STBY)

Notes on the sheet:
High-Speed CAN

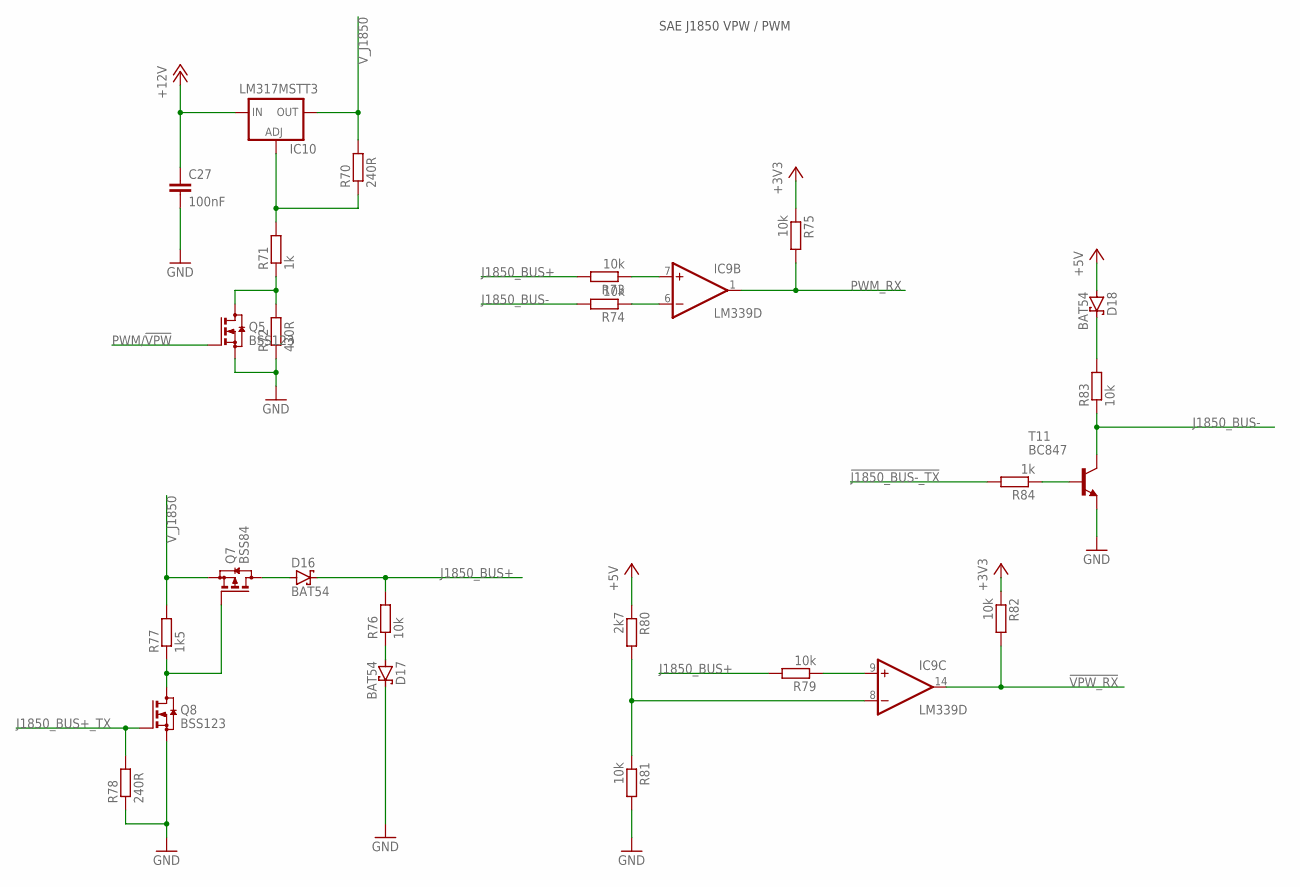
[picture p37: schematic qsd67lc_v2.sch, sheet 11, OBDII SAE J1850 VPW PWM]

Parts:
C27: 100nF; C0805
D16, D17, D18: BAT54; SOT23
IC9: LM339D; SO14
IC10: LM317MSTT3; SOT223
Q5, Q8: BSS123; SOT23
Q7: BSS84; SOT23
R70, R78: 240R; R0805
R71, R84: 1k; R0805
R72: 430R; R0805
R73, R74, R75, R76, R79, R81, R82, R83: 10k; R0805
R77: 1k5; R0805
R80: 2k7; R0805
T11: BC847; SOT23

Connections:
!J1850_BUS-_TX: R84.2; also elsewhere on the board
!VPW_RX: IC9.14 (OUT), R82.2; also elsewhere on the board
+3V3: R75.1, R82.1; also elsewhere on the board
+5V: D18.1 (A), R80.1; also elsewhere on the board
+12V: C27.1, IC10.3 (IN); also elsewhere on the board
GND: C27.2, D17.3 (C), Q5.2 (S), Q8.2 (S), R72.1, R78.1, R81.2, T11.2 (E); also elsewhere on the board
J1850_BUS+: D16.3 (C), R73.2, R76.2, R79.2; also elsewhere on the board
J1850_BUS+_TX: Q8.1 (G), R78.2; also elsewhere on the board
J1850_BUS-: R74.2, R83.1, T11.3 (C); also elsewhere on the board
unnamed: IC10.1 (ADJ), R70.1, R71.2
unnamed: Q5.3 (D), R71.1, R72.2
unnamed: IC9.7 (+IN), R73.1
unnamed: IC9.6 (-IN), R74.1
unnamed: D16.1 (A), Q7.3 (D)
unnamed: D17.1 (A), R76.1
unnamed: Q7.1 (G), Q8.3 (D), R77.1
unnamed: IC9.9 (+IN), R79.1
unnamed: IC9.8 (-IN), R80.2, R81.1
unnamed: D18.3 (C), R83.2
unnamed: R84.1, T11.1 (B)
PWM/!VPW: Q5.1 (G); also elsewhere on the board
PWM_RX: IC9.1 (OUT), R75.2; also elsewhere on the board
V_J1850: IC10.4 (OUT), Q7.2 (S), R70.2, R77.2

Notes on the sheet:
SAE J1850 VPW / PWM

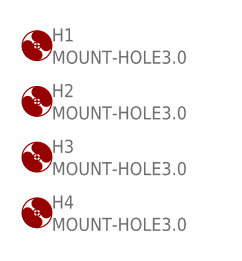
[picture p38: schematic qsd67lc_v2.sch, sheet 12, holes]

Parts:
H1, H2, H3, H4: MOUNT-HOLE3.0; 3,0

Board: 2 copper layers, 143 parts (3 on the bottom side), 103 nets, no tracks yet.
