L31N/QSD67LC/(commit log)

2018-09-25 added mountholes added atmega8 (incl. leds, switches)
    [qsd67lc.sch]
2018-09-25 changed supply from 5V to 3V3
    [qsd67lc.sch]
2018-09-25 added hc05 circuits
    [qsd67lc.sch]
2018-10-04 removed OBDII interface added ignition power circuit
    [qsd67lc.brd, qsd67lc.sch]
2018-10-04 added rs232 for direct PC communication
    [qsd67lc.brd, qsd67lc.sch]
2018-10-13 added connectors fixed rs232 dsub9 pinning added current supply circuit
    [qsd67lc.brd, qsd67lc.sch]
2018-10-13 added correct connector devices
    [qsd67lc.brd, qsd67lc.sch]
2018-10-13 started with the layout
    [qsd67lc.brd, qsd67lc.sch]
2018-10-14 added zener diode for overvoltage protection
    [qsd67lc.brd, qsd67lc.sch]
2018-10-14 added an ftdi chip to use usb directly instead of rs232 dsub connector
    [qsd67lc.brd, qsd67lc.sch]
2018-10-15 working commit
    [qsd67lc.brd, qsd67lc.sch]
2018-10-15 added galvanic decoupling for usb completed ftdi circuit
    [qsd67lc.brd, qsd67lc.sch]
2018-10-15 replaced the 6n137 by an iso7221 because of 3V3 compatibility
    [qsd67lc.brd, qsd67lc.sch]
2018-10-15 first placement of all parts
    [qsd67lc.brd, qsd67lc.sch]
2018-10-15 working commit: * moved drill hole * removed 1 button * replaced status leds * moved ground planes
    [qsd67lc.brd, qsd67lc.sch]
2018-10-15 routed ftdi part
    [qsd67lc.brd, qsd67lc.sch]
2018-10-17 finished layout added some test probe pins to 3v3 12V and GND added lables to leds, connectors and pinheads
    [qsd67lc.brd, qsd67lc.sch]
2018-10-17 added elcrow compatible gerber files
2019-02-11 started development of v2 prototype containing OBDII diagnostics capabilities.
    [qsd67lc.brd, qsd67lc.csv, qsd67lc_v2.sch]
2019-02-11 added ISO 9141 transceiver circuit
    [qsd67lc_v2.sch]
2019-02-11 implemented CAN and SAE 1850 driver circuits
    [qsd67lc_v2.sch]
2019-02-12 added k-line-adapter schematic and board finished first shot of qsd67lc_v2 schematic
    [k-line-adapter.brd, k-line-adapter.sch, qsd67lc_v2.sch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]
2020-06-19 working on kline adapter ...
    [k-line-adapter.brd, k-line-adapter.sch, qsd67lc_v2.brd, qsd67lc_v2.sch]
2020-06-19 removed doubled pullup resistor for QS+ (R14)
    [qsd67lc.brd, qsd67lc.sch]
2020-06-19 replaced the 8 bit by an 16 bit timer to achieve longer measurement intervals
    [main.cpp]
2020-06-19 added led indication weather threshold is reached or not
2020-06-22 inverted shift sensor signal -> working way on bike
    [main.cpp]
